MichaelMIL/intent2026/04-fab/drc-report.txt

** Drc report for intent-2026-badge.kicad_pcb **
** Created on 2026-10-29T23:50:27 **
** Report includes: Errors, Warnings, Exclusions **

** Found 2 DRC violations **
[silk_edge_clearance]: Silkscreen clipped by board edge
    Rule: board setup constraints silk; warning (excluded)
    @(156.0000 mm, 61.0000 mm): Segment on Edge.Cuts
    @(155.1500 mm, 98.9000 mm): Segment of J1 on F.Silkscreen
[silk_edge_clearance]: Silkscreen clipped by board edge
    Rule: board setup constraints silk; warning (excluded)
    @(156.0000 mm, 61.0000 mm): Segment on Edge.Cuts
    @(155.1500 mm, 108.3000 mm): Segment of J1 on F.Silkscreen

** Found 0 unconnected pads **

** Found 0 Footprint errors **

** Ignored checks **
    - Footprint has no courtyard defined
    - Track endpoint not centered on via
    - Tuning profile track geometries
    - Footprint doesn't match symbol's footprint filters
    - Silkscreen clearance
    - Footprint component type doesn't match footprint pads
    - Footprint not found in libraries
    - Footprint doesn't match copy in library

** End of Report **
