MichaelMIL/intent2026/04-fab/cpl_rotation_report.txt

CPL corrections applied (JLC/EasyEDA footprint orientation vs KiCad):
D1    C2286      KiCad rot   0.0 -> JLC rot 180.0, offset (-0.000, -0.000) mm, fit err 0.037 mm
D2    C2286      KiCad rot   0.0 -> JLC rot 180.0, offset (-0.000, -0.000) mm, fit err 0.037 mm
D3    C2286      KiCad rot   0.0 -> JLC rot 180.0, offset (-0.000, -0.000) mm, fit err 0.037 mm
D4    C2286      KiCad rot   0.0 -> JLC rot 180.0, offset (-0.000, -0.000) mm, fit err 0.037 mm
D5    C2286      KiCad rot   0.0 -> JLC rot 180.0, offset (-0.000, -0.000) mm, fit err 0.037 mm
Q1    C22469449  KiCad rot   0.0 -> JLC rot 180.0, offset (0.054, 0.000) mm, fit err 0.145 mm
Q2    C2146      KiCad rot   0.0 -> JLC rot 180.0, offset (0.054, 0.000) mm, fit err 0.145 mm
U2    C2456211   KiCad rot   0.0 -> JLC rot 270.0, offset (-0.000, 0.000) mm, fit err 0.207 mm
U4    C2827654   KiCad rot   0.0 -> JLC rot 270.0, offset (0.000, -0.000) mm, fit err 0.012 mm

NOT verifiable by pad geometry (symmetric pad pattern, 0 and 180 deg fit equally; 0 assumed).
Check these in the JLC placement preview before paying:
  D6     C7420330   SOD-123 Schottky: cathode (KiCad pad 1) towards U3 / VSYS. Reversed = no USB power.
  U5     C91447     IRM-H638T: GND pair (pins 1,2) on the J4 side. 180 deg wrong puts VCC on a GND pad.
  LED1-4 C52917434  WS2812B-2020: pin 1 (DOUT) corner as in the KiCad footprint.
  Y1     C20625731  ABM8-272-T3 3225 crystal: 180 deg is harmless, 90 deg shorts the crystal to GND.
  D1-D5  C2286      cathode = KiCad pad 1 (CPL already rotated 180 deg for JLC).
  D7     C81598     1N4148W SOD-123 on the SPK module: cathode (KiCad pad 1) towards SPM_3V3 / LS1 side.
  LS1    C94599     MLT-8530: lead row (+/-) towards the module header P3. The footprint wires the dummy pads
                    crosswise, so 180 deg only reverses the coil; 90 deg = silent but harmless.
  J5-J7  C42163131  SAO 2x3 SMD socket, P1-P3 C3294461 SAO 2x3 SMD header: a 180 deg error swaps 3V3/GND with
                    GPIO pins: pin 1 must match the silk triangle.
rev 0.6 parts with NO JLC footprint data in jlc_footprints.json (no correction applied, check in the preview):
  J1 C165948 HRO TYPE-C-31-M-12, U3 C51118 AP2112K SOT-23-5 (pin 1 = VIN), U6 C100024 SN74LV1T34 SOT-23-5,
  J5-J7 C42163131, P1-P3 C3294461, U7 C967633 LSM6DS3TR-C LGA-14 (pin 1 dot!), J3 C160352.
