MichaelMIL/intent2026/04-fab/erc-report.txt

ERC report (2026-10-29T23:01:08, Encoding UTF8)
Report includes: Errors, Warnings, Exclusions

***** Sheet /
[pin_to_pin]: Pins of type Bidirectional and Power output are connected
    ; warning
    @(96.52 mm, 368.30 mm): Symbol U7 Pin 1 [SDO/SA0, Bidirectional, Line]
    @(535.94 mm, 302.26 mm): Symbol #FLG073 Pin 1 [Power output, Line]
[pin_to_pin]: Pins of type Bidirectional and Power output are connected
    ; warning
    @(96.52 mm, 370.84 mm): Symbol U7 Pin 2 [SDX, Bidirectional, Line]
    @(535.94 mm, 302.26 mm): Symbol #FLG073 Pin 1 [Power output, Line]

 ** ERC messages: 2  Errors 0  Warnings 2

 ** Ignored checks:
    - Global label only appears once in the schematic
    - Four connection points are joined together
    - SPICE model issue
    - Assigned footprint doesn't match footprint filters
