MichaelMIL/intent2026/01-spec/rp2040-review-2026-10-17.md

# INTENT 2026 badge: schematic/BOM review vs RP2040 reference design (2026-10-17)

Reference: Raspberry Pi *Hardware design with RP2040* (RP-008279-DS), chapter 2 "Minimal design example".
Tooling: kicad-happy @ 6a91aaa (analyze_schematic, analyze_pcb --full, cross_analysis, analyze_emc,
analyze_thermal, analyze_gerbers) run on the working-tree schematic (includes the C10/C18/C26 edit, see §0)
and the committed rev 0.5 PCB / gerbers.

## Verdict

Not ready to order. The RP2040 core matches the reference except for the VREG decoupling (now fixed in the
schematic, not yet on the PCB) and the crystal choice. The real design risks are on the power side: the
WS2812 LEDs on VSYS (supply range and data level) and the 3V3 regulator current budget. Two new items from
kicad-happy are worth acting on: no capacitor on VBUS, and USBLC6 VBUS pin undecoupled.

## 0. State of the files (updated after the user's decisions)

All items below except TP1–TP3 (kept) were applied to `design.py` / `gen_sch.py` and the schematic was
regenerated: `check_sch.py --erc` 317 pins, 79 nets, 0 problems, ERC 0 errors / 0 warnings. BOM changes are in
`00-bom/bom-deltas.md` (rev 0.6) and the Hebrew mirror. RGB went with the buffer (SN74LV1T34, C100024), because no
LCSC/JLC addressable LED is rated for a 3.0–3.3 V supply. The PCB is not re-laid out yet (BUILD-NOTES item 14).

## 1. Blockers / should-fix

| # | Item | Evidence | Proposal |
|---|---|---|---|
| 1 | VREG decoupling | Guide §2.1.3: "1 µF capacitors close to both the input (VREG_IN) and the output (VREG_OUT)", 100 nF per DVDD pin. Old netlist: 100 nF on VREG_VIN, one 1 µF shared VREG_VOUT/DVDD50 | Done in schematic (§0). PCB: place C26 by pin 45, C18 by pin 44 |
| 2 | Crystal | Y1 C133334 is CL 20 pF; analyzer: effective load 10.5 pF (15 pF/2 + 3 pF stray). Guide §2.3.1 recommends ABM8-272-T3 (CL 10 pF, ESR 50 Ω, ±30 ppm) tuned with 15 pF + 1 kΩ | Swap Y1 → ABM8-272-T3, LCSC **C20625731** (3225-4P, same footprint, ~$0.38 @1k, 6.6k stock). Keep C11/C12 15 pF, R13 1 k |
| 3 | WS2812B-2020 on VSYS | Datasheet: VDD 3.7–5.3 V, VIH = 0.7·VDD. Battery end-of-life VSYS ≈ 3.0 V (below range: blue/green fail first). On USB VSYS ≈ 4.6 V → VIH ≈ 3.2 V vs a 3.3 V GPIO (no margin). Analyzer: 4 LEDs ≈ 240 mA peak on VSYS | (a) Keep VSYS supply, add 74AHCT1G125 (VCC = VSYS) as data buffer: fixes level, not low battery. (b) Move LEDs to +3V3 with a part rated for 3.3 V supply (part to be selected; needs the bigger LDO, item 4). Firmware brightness cap either way |
| 4 | U3 current budget | ME6206 is a 200 mA-class LDO. Load: RP2040 + flash (~30–50 mA) + speaker module 95 mA + IR + J2 3V3 | Swap to **AP2112K-3.3TRG1, LCSC C51118** (600 mA, 250 mV dropout @600 mA, Vin max 6 V). Note: LCSC C23380830 is a TECH PUBLIC part with the same MPN, not Diodes. SOT-23-5: 1 VIN, 2 GND, 3 EN → VIN, 4 NC, 5 VOUT. Caps: keep C9 10 µF in, C20 1 µF → 10 µF out (0805) |
| 5 | No capacitor on VBUS (new, kicad-happy UC-001 / DC-002) | VBUS has only D6, R10, R15, U4 pin 5. USBLC6-2SC6 app note puts 100 nF on VBUS pin 5 | Add 1 µF + 100 nF on VBUS near J1/U4 (stay ≤ 10 µF for USB inrush) |

## 2. Your list, item by item

- **USB-C → HRO TYPE-C-31-M-12, LCSC C165948**: agree. 16P USB 2.0, $0.10 @1k, 348k stock. Needs a footprint
  in `gen_fp.py` from the EasyEDA data, J1 re-placement and local re-route. The current J1 courtyard overhangs
  the edge by 0.54 mm (PM-002); recheck after the swap. CC 5.1 k ×2, 27 Ω series, USBLC6 all match the guide §2.4.1.
- **U3 → AP2112K-3.3**: agree, see item 4.
- **Expansion ports → SAO**: SAO = 2×3 2.54 mm, keyed female socket on the badge, shrouded male header on the
  add-on. Pins 1 3V3, 2 GND, 3 SDA, 4 SCL, 5 GPIO1, 6 GPIO2. Implications: shared I²C bus + pull-ups (e.g. 4.7 k)
  on the badge, GPIO1/GPIO2 per port (IR_OUT / AUDIO_PWM / SPK_PWM become GPIO1), 2×3 headers on the 13 × 22 mm
  cans (fits), re-route of the module area. Free I²C-capable pins: GPIO0/1 (I2C0) if TP1–3 go, or GPIO12/13,
  GPIO20/21. Spec also suggests an ID EEPROM at 0x50 on add-ons (optional for ours).
- **RGB at 3.0 V**: see item 3.
- **TP1–TP3**: not needed for users. stdio goes over USB CDC; UART0 only matters for low-level debug, and J2
  already gives SWD. They cost nothing in BOM (THT pads, not populated) but use board area. Recommend removing
  them and using GPIO0/1 as the SAO I²C bus.
- **C10 → 100 nF**: agree, done (§0).
- **VREG_VIN / VREG_VOUT decoupling**: agree, done (§0).
- **Crystal → ABM8-272-T3**: yes, switch (item 2). Drop-in footprint and it makes the existing load caps correct.

## 3. Other checks vs the reference (match unless noted)

- IOVDD 100 nF ×6, USB_VDD 100 nF, ADC_AVDD 100 nF, DVDD 100 nF ×2: match (guide even shares one cap on 48/49).
- TESTEN (pin 19) → GND; QSPI_SS 10 k pull-up + 1 k to BOOTSEL: match (guide fits the 10 k as DNF).
- RUN: 10 k pull-up, **no reset button**. On battery, entering BOOTSEL requires removing USB and batteries.
  Suggest a second TS-1187A (C318884) from RUN to GND.
- Flash W25Q16JV (2 MB) on QSPI: fine.
- USB D+/D− skew 7.5 mm and layer changes (DP-001/003): the 25 ps limit is for High Speed; irrelevant at
  12 Mbit/s full speed. False positive.

## 4. kicad-happy findings triaged

| Finding | Verdict |
|---|---|
| UC-001 no VBUS cap, DC-002 U4 no decap | Real, item 5 |
| XV-001/002 C26 missing, C10/C18 values | Expected until the PCB is regenerated |
| DS-001 / SS-001 no MPNs, no datasheets dir | Parts carry LCSC numbers only. Pin-level checks here are consistency-only except the RP2040 items checked against the HW design guide. Adding MPN fields would enable kicad-happy datasheet sync |
| FD-001 no fiducials | JLC adds panel fiducials; optional |
| PM-002 J1 courtyard over edge | Normal for edge USB-C; recheck with C165948 |
| RS-001 VBUS_SENSE no source | Analyzer artefact: it is a divider output to GPIO29/ADC3 (pin type bidirectional) |
| GP-001 / PS-002 / RP-001 plane gaps, missing stitching vias | Expected on 2-layer with +3V3/VSYS pours; worth a look at the QSPI and USB routes during the re-layout |
| IO-001 no filtering J4/J6/P2 | Badge, no EMC certification target; ignore |
| GR-004 paste/copper ratio | Expected (THT parts, mask-opening art) |
| EMC score 0/100 | Dominated by the 2-layer plane-gap rules above; not a design blocker for a badge |

## 5. Not performed / limits

- SPICE: no simulator installed (ngspice / LTspice / Xyce not found).
- Thermal: skipped by the analyzer (no power data without datasheet extraction).
- Lifecycle audit: no MPN fields.
- Datasheet sync: no `datasheets/` directory, no distributor API keys.
- ERC / DRC on the regenerated schematic: not run.

## 6. Follow-up 2026-10-18

SAO connectors changed to SMT (J5–J7 C42163131, P1–P3 C3294461). Keyed connectors checked: keyed SMT box headers exist
(BH254VS-6P C492445) but no board-mount keyed female mate, so keying is not possible within the SAO standard with stock
parts. Details in `00-bom/bom-deltas.md` rev 0.6b.
