MichaelMIL/intent2026/04-fab/archive-rev0.5/drc-report.txt

** Drc report for intent-2026-badge.kicad_pcb **
** Created on 2026-10-13T23:38:59 **
** Report includes: Errors, Warnings, Exclusions **

** Found 0 DRC violations **

** Found 0 unconnected pads **

** Found 86 Footprint errors **
[footprint_symbol_field_mismatch]: Field 'Description' differs (PCB: '', Schematic: 'IOVDD')
    Local override; warning
    @(133.6000 mm, 105.0000 mm): Footprint C1
[footprint_symbol_field_mismatch]: Field 'Description' differs (PCB: '', Schematic: 'IOVDD')
    Local override; warning
    @(133.6000 mm, 96.2000 mm): Footprint C2
[footprint_symbol_field_mismatch]: Field 'Description' differs (PCB: '', Schematic: 'IOVDD')
    Local override; warning
    @(135.2000 mm, 94.6000 mm): Footprint C3
[footprint_symbol_field_mismatch]: Field 'Description' differs (PCB: '', Schematic: 'IOVDD')
    Local override; warning
    @(123.4000 mm, 104.6000 mm): Footprint C4
[footprint_symbol_field_mismatch]: Field 'Description' differs (PCB: '', Schematic: 'IOVDD')
    Local override; warning
    @(125.9000 mm, 105.2000 mm): Footprint C5
[footprint_symbol_field_mismatch]: Field 'Description' differs (PCB: '', Schematic: 'flash VCC')
    Local override; warning
    @(134.0000 mm, 114.0000 mm): Footprint C6
[footprint_symbol_field_mismatch]: Field 'Description' differs (PCB: '', Schematic: 'USB_VDD')
    Local override; warning
    @(124.9000 mm, 107.2000 mm): Footprint C7
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
    Local override; warning
    @(147.1000 mm, 164.3000 mm): Footprint D7
[footprint_symbol_field_mismatch]: Field 'Description' differs (PCB: '', Schematic: 'Mounting Hole without connection')
    Local override; warning
    @(112.0000 mm, 55.5000 mm): Footprint H1
[footprint_symbol_field_mismatch]: Field 'Description' differs (PCB: '', Schematic: 'Mounting Hole without connection')
    Local override; warning
    @(144.0000 mm, 55.5000 mm): Footprint H2
[footprint_symbol_field_mismatch]: Field 'Datasheet' differs (PCB: '', Schematic: 'https://www.usb.org/sites/default/files/documents/usb_type-c.zip')
    Local override; warning
    @(151.3400 mm, 134.0000 mm): Footprint J1
[footprint_symbol_field_mismatch]: Field 'Description' differs (PCB: '', Schematic: '2x13 expansion / SWD, DNP')
    Local override; warning
    @(103.6000 mm, 81.0000 mm): Footprint J2
[footprint_symbol_field_mismatch]: Field 'Description' differs (PCB: '', Schematic: 'Battery box plug, pin1 = +')
    Local override; warning
    @(120.0000 mm, 145.2000 mm): Footprint J3
[footprint_symbol_field_mismatch]: Field 'Description' differs (PCB: '', Schematic: 'Audio Jack, 4 Poles (TRRS)')
    Local override; warning
    @(129.0000 mm, 159.0000 mm): Footprint J4
[footprint_symbol_field_mismatch]: Field 'Description' differs (PCB: '', Schematic: 'Expansion port IR: 1 = GND, 2 = 3V3, 3 = IR_OUT')
    Local override; warning
    @(104.5000 mm, 132.4600 mm): Footprint J5
[footprint_symbol_field_mismatch]: Field 'Description' differs (PCB: '', Schematic: 'Expansion port AUDIO: 1 = GND, 2 = 3V3, 3 = AUDIO_PWM')
    Local override; warning
    @(111.5000 mm, 132.4600 mm): Footprint J6
[footprint_symbol_field_mismatch]: Field 'Description' differs (PCB: '', Schematic: 'Expansion port SPK: 1 = GND, 2 = 3V3, 3 = SPK_PWM')
    Local override; warning
    @(118.5000 mm, 132.4600 mm): Footprint J7
[footprint_symbol_field_mismatch]: Field 'Description' differs (PCB: '', Schematic: 'Solder Jumper, 2-pole, closed/bridged')
    Local override; warning
    @(130.5000 mm, 141.0000 mm): Footprint JP1
[footprint_symbol_field_mismatch]: Field 'Datasheet' differs (PCB: '', Schematic: 'https://cdn-shop.adafruit.com/product-files/4684/4684_WS2812B-2020_V1.3_EN.pdf')
    Local override; warning
    @(144.0000 mm, 86.0000 mm): Footprint LED1
[footprint_symbol_field_mismatch]: Field 'Datasheet' differs (PCB: '', Schematic: 'https://cdn-shop.adafruit.com/product-files/4684/4684_WS2812B-2020_V1.3_EN.pdf')
    Local override; warning
    @(134.0000 mm, 86.0000 mm): Footprint LED2
[footprint_symbol_field_mismatch]: Field 'Datasheet' differs (PCB: '', Schematic: 'https://cdn-shop.adafruit.com/product-files/4684/4684_WS2812B-2020_V1.3_EN.pdf')
    Local override; warning
    @(124.0000 mm, 86.0000 mm): Footprint LED3
[footprint_symbol_field_mismatch]: Field 'Datasheet' differs (PCB: '', Schematic: 'https://cdn-shop.adafruit.com/product-files/4684/4684_WS2812B-2020_V1.3_EN.pdf')
    Local override; warning
    @(114.0000 mm, 86.0000 mm): Footprint LED4
[footprint_symbol_field_mismatch]: Field 'Description' differs (PCB: '', Schematic: 'Magnetic transducer 2.7 kHz, 16 ohm, 95 mA max')
    Local override; warning
    @(144.0000 mm, 158.0000 mm): Footprint LS1
[footprint_symbol_field_mismatch]: Field 'Description' differs (PCB: '', Schematic: 'Module pins, mate with J5')
    Local override; warning
    @(109.4600 mm, 171.0000 mm): Footprint P1
[footprint_symbol_field_mismatch]: Field 'Description' differs (PCB: '', Schematic: 'Module pins, mate with J6 (3V3 pin unused)')
    Local override; warning
    @(125.4600 mm, 171.0000 mm): Footprint P2
[footprint_symbol_field_mismatch]: Field 'Description' differs (PCB: '', Schematic: 'Module pins, mate with J7')
    Local override; warning
    @(141.4600 mm, 171.0000 mm): Footprint P3
[footprint_symbol_field_mismatch]: Field 'Datasheet' differs (PCB: '', Schematic: 'http://www.aosmd.com/pdfs/datasheet/AO3401A.pdf')
    Local override; warning
    @(135.6000 mm, 132.4000 mm): Footprint Q1
[footprint_symbol_field_mismatch]: Field 'Description' differs (PCB: '', Schematic: 'NPN low-side driver')
    Local override; warning
    @(140.7000 mm, 164.9500 mm): Footprint Q2
[footprint_symbol_field_mismatch]: Field 'Description' differs (PCB: '', Schematic: 'Resistor')
    Local override; warning
    @(146.4000 mm, 136.6000 mm): Footprint R1
[footprint_symbol_field_mismatch]: Field 'Description' differs (PCB: '', Schematic: 'Resistor')
    Local override; warning
    @(146.4000 mm, 131.4000 mm): Footprint R2
[footprint_symbol_field_mismatch]: Field 'Description' differs (PCB: '', Schematic: 'Resistor')
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
    Local override; warning
    @(137.0000 mm, 145.0000 mm): Footprint TP1
[footprint_symbol_field_mismatch]: Field 'Description' differs (PCB: '', Schematic: 'test point')
    Local override; warning
    @(140.5000 mm, 145.0000 mm): Footprint TP2
[footprint_symbol_field_mismatch]: Field 'Description' differs (PCB: '', Schematic: 'test point')
    Local override; warning
    @(144.0000 mm, 145.0000 mm): Footprint TP3
[footprint_symbol_field_mismatch]: Field 'Datasheet' differs (PCB: '', Schematic: 'https://datasheets.raspberrypi.com/rp2040/rp2040-datasheet.pdf')
    Local override; warning
    @(128.0000 mm, 100.0000 mm): Footprint U1
[footprint_symbol_field_mismatch]: Field 'Datasheet' differs (PCB: '', Schematic: 'http://www.winbond.com/resource-files/w25q32jv%20revg%2003272018%20plus.pdf')
    Local override; warning
    @(130.0000 mm, 110.8000 mm): Footprint U2
[footprint_symbol_field_mismatch]: Field 'Datasheet' differs (PCB: '', Schematic: 'https://www.torexsemi.com/file/xc6206/XC6206.pdf')
    Local override; warning
    @(129.6000 mm, 135.6000 mm): Footprint U3
[footprint_symbol_field_mismatch]: Field 'Datasheet' differs (PCB: '', Schematic: 'https://www.st.com/resource/en/datasheet/usblc6-2.pdf')
    Local override; warning
    @(144.4000 mm, 134.0000 mm): Footprint U4
[footprint_symbol_field_mismatch]: Field 'Datasheet' differs (PCB: '', Schematic: 'https://en.everlight.com/wp-content/plugins/ItemRelationship/product_files/pdf/DMO-0000004-IRM-H6XX-TR2_Series_Datasheet_V4.pdf')
    Local override; warning
    @(112.0000 mm, 157.0000 mm): Footprint U5
[footprint_symbol_field_mismatch]: Field 'Description' differs (PCB: '', Schematic: 'Four pin crystal, GND on pins 2 and 4')
    Local override; warning
    @(129.2000 mm, 93.0000 mm): Footprint Y1

** Ignored checks **
    - Footprint has no courtyard defined
    - Track endpoint not centered on via
    - Tuning profile track geometries
    - Footprint doesn't match symbol's footprint filters
    - Silkscreen clearance
    - Footprint component type doesn't match footprint pads
    - Footprint not found in libraries
    - Footprint doesn't match copy in library

** End of Report **
