MichaelMIL/intent2026/04-fab/archive-rev0.5/erc-report.txt

ERC report (2026-10-13T23:38:57, Encoding UTF8)
Report includes: Errors, Warnings, Exclusions

***** Sheet /
[lib_symbol_mismatch]: Symbol 'USB_C_Receptacle_USB2.0_16P' doesn't match copy in library 'Connector'
    ; warning
    @(55.88 mm, 68.58 mm): Symbol J1 [USB_C_Receptacle_USB2.0_16P]

 ** ERC messages: 1  Errors 0  Warnings 1

 ** Ignored checks:
    - Global label only appears once in the schematic
    - Four connection points are joined together
    - SPICE model issue
    - Assigned footprint doesn't match footprint filters
