MichaelMIL/intent2026/00-bom/bom-deltas-he.md

# תיקוני BOM — מה נדרש ולמה (עברית)

כל התיקונים נובעים מהשוואה בין ה-BOM לבין המדריך הרשמי של Raspberry Pi,
*Hardware design with RP2040* (פרק "Minimal Design Example"), ומדפי הנתונים של הרכיבים.

## 1. הסרת L1 — סליל 3.3µH — **נדרש**
ה-BOM מתאר אותו כ-"RP2040 1V1 buck". ל-RP2040 **אין** ממיר buck. יש לו רגולטור ליניארי פנימי (LDO)
שמוריד 3.3V ל-1.1V לליבה, והוא דורש רק קבל 1µF על VREG_VOUT. הסליל הזה שייך ל-**RP2350** (הדור הבא),
שבו באמת יש ממיר מיתוגי. אם נשאיר אותו — אין לו לאן להתחבר בסכמה. בונוס: זה היה הרכיב היחיד עם מלאי
נמוך (1,900 יח'), והוא נעלם.

## 2. נגדי 27Ω על קווי USB D+/D- — **נדרש**
במדריך של Raspberry Pi הם חובה. הרציונל: הדרייבר של ה-USB ב-RP2040 הוא "חזק מדי" ביחס לאימפדנס
הקווים (90Ω דיפרנציאלי). הנגדים בטור מתאימים את האימפדנס ומרככים את הקצוות של האותות, וכך האות עומד
בדרישות ה-eye diagram של USB 2.0 Full-Speed. בלי הנגדים לוחות **לרוב** יעבדו, אבל חלק מהמחשבים/כבלים
יתנו ניתוקים אקראיים — בדיוק סוג הבאג שקשה לאתר ב-600 יחידות בשטח. עלות: ~$0.004 ללוח, רכיב basic.

## 3. נגד 1kΩ בטור ל-XOUT של הגביש — **מומלץ מאוד**
המדריך דורש אותו. הוא מגביל את ה-drive level של הגביש (12MHz). בלי הנגד הגביש מקבל יותר הספק ממה
שהוא מתוכנן לו — זה מקצר את חייו, מזיז את התדר, ולעיתים גורם לגביש "לקפוץ" להרמוניה. התדר הזה הוא
מקור השעון של ה-USB, אז סטייה בו = USB לא יציב. עלות: אפס (אותו נגד 1kΩ שכבר ב-BOM).

## 4. נגד 1kΩ בין לחצן BOOTSEL ל-GND — **מומלץ**
ב-Pico זה בדיוק כך. QSPI_SS הוא גם קו ה-chip-select של ה-flash. כשהלחצן נלחץ תוך כדי שה-RP2040
מוציא עליו '1', בלי הנגד יש קצר ישיר של הפלט ל-GND. הנגד מגביל את הזרם ל-~3mA, שהפין סובל. עלות: אפס.

## 5. קבלי 100nF: 12 → 16 — **נדרש**
ל-RP2040 יש 10 פיני הזנה: 6× IOVDD, 2× DVDD, USB_VDD, ADC_AVDD (ועוד VREG_VIN). הכלל: קבל 100nF
צמוד לכל פין. ה-BOM הקצה 8 קבלים לכל הלוח — RP2040 + flash + LDO — כלומר חסרים לפחות 2–3 לשבב
עצמו. בלי decoupling לכל פין מקבלים רעש על ההזנה, רעש ב-ADC, ו-USB רגיש. עלות: ~$0.012 ללוח.

## 6. קבל 1µF על יציאת ה-LDO (3V3) — **נדרש**
דף הנתונים של ME6206 דורש לפחות 1µF קרמי על היציאה ליציבות. ב-BOM היה רק 10µF על הכניסה
ו-1µF אחד שמיועד ל-VREG_VOUT של ה-RP2040. בלי קבל יציאה ה-LDO יכול להתנדנד (oscillate) — זה נראה
כמו רעש של 3V3 ואיפוסים אקראיים. עלות: ~$0.007 ללוח (אותו רכיב).

## 7. פד לנגד דמפינג על קו הנתונים ל-RGB — **אופציונלי, $0**
WS2812 רגישים ל-ringing על קו הנתונים. משאירים פד 0402 בין GPIO10 ל-LED1; אם לא צריך — מגשרים.

## סיכום
| | לפני | אחרי |
|---|---|---|
| סוגי רכיבים | 17 | 17 (−L1, +27Ω) |
| נקודות הלחמה | 188 | ~206 |
| עלות רכיבים @600 | $2.04 | ~$2.04 (±$0.01) |
| סיכון מלאי | L1: 1,900 | אין |

כולם נכנסו ל-`design-spec.md` כ-R11–R14, C17–C20. אם אתה רוצה לדלג על משהו — סעיפים 3, 4, 7 הם
ה"רכים"; 1, 2, 5, 6 אני לא הייתי מוותר עליהם.

---

# גרסה 0.5 — מקלט IR, שקע אודיו ורמקול כמודולים נתיקים (החלטה 2026-10-11)

מקלט ה-IR ושקע האודיו יורדים מהלוח הראשי, מתווסף רמקול (תוספת 7 ב-BOM-B2), ושלושתם יושבים על
**לוחות-משנה נתיקים מתחת לבסיס** של מכונת המכירה: אותו PCB, מחוברים בלשוניות ברוחב 4 מ"מ עם
"נשיכות עכבר" (mouse bites), **בלי נחושת שחוצה את הלשוניות**. על כל מודול יש מחבר פינים 1×3 (P1–P3) שנכנס
לשקע 1×3 תואם על הלוח הראשי (J5–J7). פינאוט זהה בכל השקעים: **1 = GND (פד מרובע), 2 = 3V3, 3 = אות**.
ההספק באמצע, ולכן מודול שמוכנס הפוך רק מחליף בין GND לאות ולעולם לא מביא 3V3 אל GPIO.
גודל הלוח הגולמי גדל מ-56×100 ל-56×124 מ"מ (המודולים הם פחיות 13×22 מ"מ).

| רכיב | LCSC | תיאור | כמות | סוג חדש? | היכן |
|---|---|---|---|---|---|
| J5, J6, J7 | C541850 | שקע נקבה 1×3, 2.54 מ"מ, THT | 3 | כן (ext) | לוח ראשי, אזור המטבעות: IR / AUDIO / SPK (GPIO22 / 11 / 25) |
| P1, P2, P3 | C49257 | מחבר פינים 1×3, 2.54 מ"מ, THT | 3 | כן (ext) | אחד על כל מודול |
| U5, R19, C23, C24 | כמו קודם | מקלט IR + מסנן RC | 4 | לא | **מודול IR** (רשתות IRM_*) |
| J4, R17, C21, C22 | כמו קודם | שקע אודיו + מסנן PWM | 4 | לא | **מודול אודיו** (רשתות AUM_*; פין 2 לא בשימוש) |
| LS1 | C94599 | MLT-8530, זמזם מגנטי SMD, 2.7 kHz, 16Ω | 1 | כן (ext) | **מודול רמקול**, עד 95mA, מוזן מ-3V3 |
| Q2 | C2146 | S8050 NPN, SOT-23 | 1 | כן (basic) | מודול רמקול, מתג low-side |
| D7 | C81598 | 1N4148W, SOD-123 | 1 | כן (basic) | מודול רמקול, דיודת flyback. **מלאי LCSC הראה 300 ב-2026-10-11 — לבדוק מלאי JLC או לבחור 1N4148W אחר** |
| R20, R21 | C11702, C25744 | 1kΩ לבסיס, 10kΩ pull-down | 2 | לא | מודול רמקול |
| C25 | C7503495 | 10µF 0805 | 1 | לא | מודול רמקול, קבל מקומי לפולסי הסליל |

סוגי רכיבים: 23 → 28. הלחמות: ≈240 → ≈262 SMD + **18 THT** (המחברים מולחמים ידנית ב-JLC: $3.50 להזמנה +
$0.0173 להלחמה). GPIO25 נתפס לרמקול (נשאר גם על J2 פין 15 כאות משותף); נשארים 15 GPIO פנויים על J2.

**עלות (הערכה גסה, 600 לוחות, כולל מע"מ): ≈ +$0.9–1.0 ללוח** — מחברים ≈$0.24, הלחמות THT ≈$0.31,
רכיבי הרמקול ≈$0.26, PCB גדול ב-18% ≈$0.10. ב-10 לוחות העמלות הקבועות (5 סוגים חדשים × $1.53 + $3.50)
מוסיפות ≈ +$2.5 ללוח. **אפשרות זולה יותר:** להשאיר את J5–J7 ו-P1–P3 לא מורכבים (DNP, כמו J2) ולצרף מחברים
בשקית — חוסך ≈$0.55 ללוח, אבל אז צריך להלחים לפני שמודול כלשהו עובד.

למה כך: המודולים תלויים מתחת לבסיס כדי שהתג ישמור על צללית 56×100 אחרי הניתוק; נשיכות העכבר יושבות על
קצה הבסיס, כך שהשארית נשארת על המודול ולא על התג. לרשתות המודולים יש שמות משלהן, שום דבר לא עובר דרך
הלשוניות, ולכן ה-DRC על הפאנל אמין. השקעים אנכיים — מודול מחובר עומד כמו מוצר בחלון; העדשה של ה-IR
ופתח הקול פונים הצידה. אם מעדיפים מודול שוכב שפונה קדימה, מחליפים את P1–P3 למחברים בזווית ישרה
(`PinHeader_1x03_P2.54mm_Horizontal`, אותם פדים). ה-footprint של הזמזם מחבר את שני פדי הדמה בצלב לפדי
הסליל, כך ששגיאת 180° בהרכבה רק הופכת את קוטביות הסליל, ו-90° משתיק בלי נזק.

---

# גרסה 0.6 — בדיקה מול מדריך התכנון של RP2040 (2026-10-17)

בדיקת המשתמש + הרצת kicad-happy (דוח: `01-spec/rp2040-review-2026-10-17.md`). השינויים הוכנסו ל-`design.py`
ולסכמה; ה-PCB **עוד לא** עודכן (footprints חדשים: J1, U3, U6, J5–J7, P1–P3; רכיבים חדשים C26–C29, R22, R23,
SW6). TP1–TP3 נשארים (החלטת המשתמש).

| רכיב | שינוי | LCSC | למה |
|---|---|---|---|
| C18 | 100nF → **1µF** | C6119792 | מדריך §2.1.3: ‏1µF על VREG_VIN |
| C10 | 1µF → **100nF** | C60474 | עכשיו רק DVDD פין 50 |
| C26 | **חדש** 1µF על +1V1 | C6119792 | מדריך §2.1.3: ‏1µF על VREG_VOUT |
| Y1 | C133334 (CL 20pF) → **Abracon ABM8-272-T3** | **C20625731** | הגביש של המדריך; CL 10pF מתאים לקבלי 15pF ול-1k. אותו footprint ‏3225 |
| U3 | ME6206A33M3G → **AP2112K-3.3TRG1** (SOT-23-5, EN ל-VIN) | **C51118** | ‏600mA במקום LDO של ‏200mA. C23380830 הוא יצרן אחר עם אותו MPN |
| C20 | 1µF → **10µF 0805** | C7503495 | קבל יציאה של ה-LDO |
| J1 | TYPE-C-16PIN C393939 → **HRO TYPE-C-31-M-12** | **C165948** | הרכיב שעבד אצל המשתמש; footprint סטנדרטי של KiCad |
| C27, C28 | **חדש** 1µF + 100nF על VBUS | C6119792, C60474 | לא היה קבל על VBUS בכלל |
| SW6 | **חדש** כפתור RESET (RUN ל-GND) | C318884 | משתמשי סוללה מגיעים ל-BOOTSEL בלי לנתק |
| U6, C29 | **חדש** SN74LV1T34DBVR מוזן מ-VSYS + 100nF | **C100024**, C60474 | חוצץ נתונים ל-RGB: ‏DIN מגיע ל-VSYS, כך ש-VIH = 0.7·VDD מתקיים בכל מתח |
| J5–J7 | שקע 1×3 → **שקע 2×3 (SAO)** | **C541853** | SAO: ‏1 3V3, ‏2 GND, ‏3 SDA, ‏4 SCL, ‏5 GPIO1, ‏6 GPIO2 |
| P1–P3 | מחבר 1×3 → **מחבר 2×3 (SAO)** | **C65114** | מחבר רגיל: 2×3 עם מעטפת רחב מהפחית (13 מ"מ) |
| R22, R23 | **חדש** 4.7kΩ ‏pull-up ל-I²C | C25900 (basic) | ‏I²C0 של SAO על GPIO12/13 |

אפשרות RGB שלא נבחרה: אין ב-LCSC/JLC לד ממוען שמדורג לאספקה של 3.0–3.3V. הנמוכים ביותר: SK6805-EC20
(C2890036, ‏3.5–5.5V, ‏4 במלאי), WS2812B-MINI-V3 (3.5V), והשאר מ-3.7V. רכיבי XL-…-KS של "3V" מהבהבים
לבד ואינם ממוענים. לכן הלדים נשארים על VSYS ‏(WS2812B-2020-V6) עם החוצץ, והקושחה מכבה אותם כש-VSYS יורד
מתחת ל-≈3.7V.

עלות @600 (הערכה גסה): ≈ **+$0.95 ללוח** (גביש +$0.25, LDO ‏+$0.12, חוצץ +$0.18, מחברים +$0.05, פסיביים
+$0.05, הלחמות THT נוספות +$0.31). אם רכיבי ה-THT נשלחים DNP, שורת ה-THT יורדת.

## גרסה 0.6b — מחברי SAO ל-SMT, נבדקה אפשרות למחבר עם מפתח (2026-10-18)

| רכיב | היה (THT) | עכשיו (SMT) | LCSC | מלאי / מחיר (2026-10-18) |
|---|---|---|---|---|
| J5–J7 | PM254V-12-06-H85 C541853 | **HC-PM254-5.0H-2x3PS-02A**, שקע 2×3 SMD, גובה 5.0 מ"מ | **C42163131** | 7,625 / $0.116 |
| P1–P3 | 2.54-2*3P C65114 | **PZ254-2-03-S**, מחבר פינים 2×3 SMD | **C3294461** | 14,540 / $0.080 |

Footprints: ‏`PinSocket_2x03_P2.54mm_Vertical_SMD` / ‏`PinHeader_2x03_P2.54mm_Vertical_SMD` של KiCad (‏≈8 מ"מ רוחב
על שתי השורות). לבדוק מול דפי הנתונים בעימוד ה-PCB. השקע רחב יותר, אז המרווח של 7 מ"מ בין השקעים לא יספיק
ו-J5–J7 יזוזו. חלופות: שקע C41397152, מחבר C780054.

השפעה: לא נשארים רכיבי THT (חוץ מ-J2 שלא מורכב), כך שעמלת ההלחמה הידנית של JLC (‏$3.50 להזמנה + 36 הלחמות
≈ $0.62 ללוח) נעלמת. נטו מול 0.6: ≈ **‎−$0.5 ללוח**.

**מחבר עם מפתח (נבדק, לא יושם):**
- יש box header עם מפתח ב-SMT: ‏**BH254VS-6P C492445** (‏4,800 במלאי, $0.16) ו-C22438045. גוף 15.27×8.8 מ"מ.
- **אין** שקע נקבה עם מפתח להרכבה על PCB שמתאים להם ב-LCSC/JLC (בן הזוג עם המפתח הוא מחבר IDC לכבל שטוח).
  שקע 2×3 רגיל נכנס לתוך המעטפת אבל החלל באורך ≈13 מ"מ מול שקע של 7.6 מ"מ, כך שאין מפתח לכיוון ולא להיסט.
- box header נכנס לפחית של 13 מ"מ רק כשהוא מסובב ב-90°, ותופס ≈15×10.5 מ"מ מתוך 13×22.
- מסקנה: אי אפשר לקבל מפתח בתוך תקן SAO עם רכיבים מהמלאי. המלצה: SMT בלי מפתח + משולשי פין 1 גדולים על התג
  ועל כל פחית, וציור הפחית כך ש"פחית עומדת" = כיוון נכון.
- מודול שלנו שמחובר הפוך (180°) מקבל 3V3 על פין 6 שלא בשימוש, ופיני ה-3V3/GND שלו נופלים על GPIO2/GPIO1: אין קצר,
  המודול פשוט לא עובד. SAO של צד שלישי עלול לקבל מתח דרך GPIO; הקושחה משאירה את GPIO1/GPIO2 ככניסות עד שמזוהה מודול.

## גרסה 0.6d — מחבר הסוללה J3 (2026-10-29, בקשת המשתמש)

| רכיב | היה | עכשיו | LCSC | הערות |
|---|---|---|---|---|
| J3 | CAX PH2.0-2P-LT, footprint מותאם (C722761) | **JST B2B-PH-SM4-TB**, ‏JST PH 2.0 מ"מ מקורי, 2 פינים SMD אנכי, עם לשוניות הלחמה | **C160352** | ‏72,150 במלאי; ‎$0.13 (1,000+). footprint סטנדרטי של KiCad: ‏`Connector_JST:JST_PH_B2B-PH-SM4-TB_1x02-1MP_P2.00mm_Vertical`. פין 1 = BAT_IN (+), פין 2 = GND כמו קודם |

- אותו תקע PH 2.0, כך שכבל קופסת הסוללות לא משתנה. לבדוק את קוטביות התקע של הקופסה מול פין 1.
- ה-footprint השתנה: צריך Update PCB from Schematic ולמקם מחדש את J3. אין עדיין נתוני סיבוב של JLC ל-C160352: לבדוק את J3 בתצוגה המקדימה של JLC.

## גרסה 0.6e — מודול האודיו הוחלף במודול IMU (2026-10-29, בקשת המשתמש)

| רכיב | שינוי | LCSC | הערות |
|---|---|---|---|
| J4, R17, C21, C22 | **הוסרו** (שקע PJ-320D ומסנן PWM) | C431535, C11702, C15195, C19702 | מודול האודיו בוטל |
| U7 | **חדש** ST **LSM6DS3TR-C**, ‏IMU בעל 6 צירים (מד תאוצה + ג'ירו), LGA-14 2.5×3 מ"מ | **C967633** | ‏22,645 במלאי; ‎$0.91 (1,000+) |
| C30, C31 | **חדש** 100nF על VDD / VDDIO | C60474 | לפי דף הנתונים |

- מצב I2C: ‏CS = VDDIO, ‏SA0 = GND ← כתובת **0x6A**, ‏SDx/SCx = GND, פינים 10/11 לא מחוברים. SDA/SCL על אפיק ה-I2C של SAO (נגדי pull-up R22/R23 על התג). INT1 → GPIO1 של SAO (GPIO11, הרשת שונתה מ-AUDIO_PWM ל-IMU_INT1), INT2 → GPIO2 של SAO (GPIO27).
- עלות ב-600: ≈ ‎+$0.95 ללוח עבור U7 והקבלים, ‎−$0.25 עבור השקע והמסנן.

## גרסה 0.6f — מחבר למסך OLED ‏0.96" (2026-10-29, בקשת המשתמש)

| רכיב | שינוי | LCSC | הערות |
|---|---|---|---|
| J8 | **חדש** שקע נקבה 1×4 ‏2.54 מ"מ SMD, ‏HX PM2.54-1x4P TP-YQ, גובה 5 מ"מ | **C42379197** | ‏15,269 במלאי. למודול OLED ‏0.96" ‏SSD1306 ב-I2C: ‏1 GND, ‏2 VCC (3V3), ‏3 SCL, ‏4 SDA, על אפיק ה-I2C של SAO. לבדוק את סדר הפינים של המודול (בחלק מהם GND ו-VCC הפוכים) |
