MichaelMIL/intent2026/04-fab/bom_jlc.csv

Comment | Designator | Footprint | LCSC Part #
100nF | C1,C2,C3,C4,C5,C6,C7,C8,C10,C13,C14,C15,C16,C17,C19,C23,C28,C29,C30,C31 | C_0402_1005Metric | C60474
10uF | C9,C20,C24,C25 | C_0805_2012Metric | C7503495
15pF | C11,C12 | C_0402_1005Metric | C1548
1uF | C18,C26,C27 | C_0402_1005Metric | C6119792
Red | D1,D2,D3,D4,D5 | LED_0603_1608Metric | C2286
B5819W | D6 | D_SOD-123 | C7420330
1N4148W | D7 | D_SOD-123 | C81598
TYPE-C-31-M-12 | J1 | USB_C_Receptacle_HRO_TYPE-C-31-M-12 | C165948
BATT 3xAAA | J3 | JST_PH_B2B-PH-SM4-TB_1x02-1MP_P2.00mm_Vertical | C160352
SAO socket 2x3 2.54mm SMD | J5,J6,J7 | PinSocket_2x03_P2.54mm_Vertical_SMD | C42163131
OLED 0.96 I2C | J8 | PinSocket_1x04_P2.54mm_Vertical_SMD_Pin1Right | C42379197
WS2812B-2020-V6 | LED1,LED2,LED3,LED4 | LED_WS2812B-2020_PLCC4_2.0x2.0mm | C52917434
MLT-8530 | LS1 | Buzzer_MLT-8530_C94599 | C94599
SAO pin header 2x3 2.54mm SMD | P1,P2,P3 | PinHeader_2x03_P2.54mm_Vertical_SMD | C3294461
HL3401 | Q1 | SOT-23 | C22469449
S8050 | Q2 | SOT-23 | C2146
5.1k | R1,R2 | R_0402_1005Metric | C25905
10k | R3,R4,R10,R15,R16,R21 | R_0402_1005Metric | C25744
1k | R5,R6,R7,R8,R9,R13,R14,R20 | R_0402_1005Metric | C11702
27 | R11,R12 | R_0402_1005Metric | C25100
100 | R19 | R_0402_1005Metric | C25076
4.7k | R22,R23 | R_0402_1005Metric | C25900
TS-1187A-B-A-B tactile 5.1x5.1 | SW1,SW2,SW3,SW4,SW6 | SW_Push_1P1T_XKB_TS-1187A | C318884
RP2040 | U1 | QFN-56-1EP_7x7mm_P0.4mm_EP3.2x3.2mm | C2040
W25Q16JVSNIQ | U2 | SOIC-8_3.9x4.9mm_P1.27mm | C2456211
AP2112K-3.3TRG1 | U3 | SOT-23-5 | C51118
USBLC6-2SC6 | U4 | SOT-23-6 | C2827654
IRM-H638T/TR2 | U5 | IRM-H638T_C91447 | C91447
SN74LV1T34DBVR | U6 | SOT-23-5 | C100024
LSM6DS3TR-C | U7 | LGA-14_3x2.5mm_P0.5mm_LayoutBorder3x4y | C967633
12MHz ABM8-272-T3 | Y1 | Crystal_SMD_3225-4Pin_3.2x2.5mm | C20625731
