MichaelMIL/intent2026/03-kicad/BUILD-NOTES.md

# 03-kicad — build notes (rev 0.6, 2026-10-18)

KiCad project, regenerated with **KiCad 10.0.3** on the Mac on 2026-10-11 (the board file is now in the v10 format; the schematic is still written in the 2025 format and opens in 9 and 10). Open `intent-2026-badge.kicad_pro`. The project folder holds custom footprints in `intent.pretty` (they are registered in `fp-lib-table`).

**rev 0.5:** the IR receiver, the audio jack and a new speaker are **breakaway modules** under the pedestal. Blank 56 × 124 mm: badge 56 × 100 + a 2 mm routed gap + three 13 × 22 mm soda-can modules on 4 mm tabs with 4 × 0.5 mm mouse bites each (MB1–MB3, board-only footprints on the pedestal edge line). Sockets J5/J6/J7 (IR/AUDIO/SPK) on the main board, pin headers P1/P2/P3 on the modules, pin 1 = GND, 2 = 3V3, 3 = signal. Module nets are prefixed IRM_/AUM_/SPM_; no copper crosses a tab; each module has its own ground pour. Details and cost in `../00-bom/bom-deltas.md` (rev 0.5) and `../01-spec/design-spec.md` §3.11.

## Status
| Check | Result |
|---|---|
| ERC | rev 0.6: 0 errors, 0 warnings (J1 is on the stock HRO footprint now, so the shield-pin rename is gone) |
| DRC (with schematic parity) | **rev 0.6: 0 errors, 0 unconnected** (KiCad 10.0.6, Windows). 31 warnings: 20 `silk_over_copper` + 10 `silk_edge_clearance` (silk clipped by mask/edge: footprint silk at the can bottoms and J1, the rotated can labels) and 1 `isolated_copper` (a sliver of AUM_GND pour on B.Cu at the AUDIO can's top-left corner). Plus the 94 cosmetic KiCad 10 `footprint_symbol_field_mismatch` notes. |
| Routing | **rev 0.6: 1677 track segments, 461 vias (87 GND stitching), full re-route (item 16).** rev 0.5: 2 layers, 1305 track segments, 378 vias (0.3/0.6) after the can re-route and the art-region via pruning (items 12–13; the rev 0.5 full run had 1313 / 412, 194 GND of which 134 stitching). Pours: GND on both layers over the badge; IRM_GND / AUM_GND / SPM_GND on the three modules. Netlist: 86 parts, 78 nets. |
| Fab outputs | `../04-fab/` (rev 0.6, 2026-10-18; rev 0.5 set in `../04-fab/archive-rev0.5/`, its routes in `build/routes_rev0.5.json`; the rev 0.4 set is in `../04-fab/archive-rev0.4/`, the rev 0.4 board in `build/rev0.4/`) |

## How the files are generated (all scripted, reproducible)
`scripts/design.py` is the netlist source of truth, and `scripts/placement.py` holds the coordinates.
1. `gen_fp.py` → `intent.pretty` (USB-C C393939, PJ-320D C431535, IRM-H638T C91447, JST-PH C722761, MLT-8530 C94599, lanyard hole, mouse bites). Pad geometry is copied from the JLC/EasyEDA footprints of those exact LCSC parts. The MLT-8530 footprint numbers its two dummy pads crosswise (1/2), so a 180° placement only reverses the coil. `gen_3d.py` → `intent.3dshapes/` simplified VRML models for these footprints and for the three stock footprints without a shipped STEP model (`pcb_build.FALLBACK_3D`); `add_3d.py` attaches them to an already finished board.
2. `gen_sch.py` → `.kicad_sch`, a **wired schematic** (2026-10-11 rework): nine blocks on one A2 sheet (USB-C, power path, expansion ports, IR module, RP2040 core, UI, header, audio module, speaker module). Rails use power symbols, every other net carries a global label with the design.py net name, so the PCB netlist is unchanged. Drawing primitives are in `schlib.py`; `check_sch.py --erc` exports the netlist and proves every (ref, pin) → net matches design.py, then runs ERC. `render_sch.py` makes a PNG for a visual check. The previous labels-only schematic is kept as `build/intent-2026-badge.kicad_sch.v1-labels.bak`.
3. `pcb_build.py` (KiCad Python) → unrouted board + `build/geo.json`. Draws the badge outline, splits the pedestal edge at the tabs, adds the tab sides and the can outlines (rectangles with the R 2.2 corners from `placement.MODULE_CORNERS`) as one closed Edge.Cuts contour, and places the mouse-bite footprints (`SetBoardOnly`, excluded from BOM/CPL and from schematic parity). `geo.json` carries the full polygon (router) and the badge-only polygon (pours, silk).
4. `router/route2.py` routes the board with a negotiated-congestion grid router: exact clearances, A* in C (`astar.c`), and a final GND fan-out pass into the main B.Cu plane.
5. `pcb_finish.py` → tracks, pours, silkscreen (`silk.py`, logo from `art_logo.py`). Pours: GND over the badge polygon only (it stops at the pedestal edge), plus IRM_GND / AUM_GND / SPM_GND over the three module rectangles. The 0.5 mm clearance on the mouse-bite holes keeps copper off the break line. `router/gnd_repair.py` + `island_stitch.py` check the main ground; module grounds are routed as ordinary nets.
6. `fab_export.py` → JLC BOM/CPL with rotation correction taken from `jlc_footprints.json`. `kicad-cli` produces the Gerbers and drill files.
`build_prep.sh` / `build_finish.sh` run the chain. 2026-10-11: run on the Mac with KiCad 10.0.3 (`scripts/env.mac.sh`, see CLAUDE.md); two KiCad 10 API renames are handled with fallbacks (`HasField`/`GetField`). The router grid was extended to y 120 for the modules (`NY = 1210`).
Router settings used for the rev 0.5 board (run from a scratch copy `$W`):
```
ROUTE_ITERS=60 FIXED_ROUTES=$W/scripts/router/fixed_routes.json GND_SKIP=U1.19 GND_LAST=1 \
GND_SUBSET=U2.4,Y1.4,C17.2,R10.2,C8.2,C7.2,C5.2,C4.2,C19.2,C18.2,C10.2,C1.2 CORR_R=6.5 HIST_INC=30 PRES_CAP=150000 \
ROUTE_STATE=$W/route_state.pkl python3 scripts/router/route2.py $W/geo.json $W/routes.json
```
`fixed_routes.json` pre-places the TESTEN (U1.19) ground fan-out to the crystal GND pad Y1.4 (the corridor between XIN and GPIO15, taken from the rev 0.4 board); the negotiation alone ended with XIN and that fan-out 0.05 mm apart. Every other net routes around fixed copper. If a run ends with a few residual conflicts that all involve GND, `router/gnd_final.py geo.json routes.json` keeps the signal nets and re-does only the GND fan-outs with hard clearance (plus stitching). `ROUTE_STATE` lets a run resume with more `ROUTE_ITERS`.
rev 0.4 settings for reference: `GND_LAST=1 GND_SUBSET=U2.4,U1.19,R10.2,C8.2,C7.2,C5.2,C4.2,C19.2,C18.2,C10.2,C1.2 CORR_R=6.5 HIST_INC=30 PRES_CAP=150000`.

## Changes against design-spec rev 0.3 (all reflected in the files)
14. **rev 0.6 schematic/BOM review (2026-10-17, user list + kicad-happy, report `../01-spec/rp2040-review-2026-10-17.md`).** `design.py` + `gen_sch.py` updated, schematic regenerated on Windows with KiCad 10.0.3 (`check_sch.py --erc`: 317 pins, 79 nets, 0 problems; ERC 0 errors, 0 warnings). Changes: VREG decoupling per the RP2040 guide (C18 1 µF VREG_VIN, C10 100 nF DVDD 50, new C26 1 µF VREG_VOUT); Y1 ABM8-272-T3; U3 AP2112K-3.3 (SOT-23-5) + C20 10 µF; J1 HRO TYPE-C-31-M-12 on the stock KiCad footprint (shield pad `SH`, so `schlib.PIN_RENAMES` is now empty and the J1 ERC warning is gone); C27/C28 on VBUS; SW6 RESET; U6 SN74LV1T34 RGB buffer + C29; J5–J7/P1–P3 → SAO 2×3 with I²C0 on GPIO12/13 (R22/R23) and GPIO2 on GPIO26–28; nets renamed GPIO10 → RGB_CTRL, GPIO12/13 → SAO_SDA/SCL, GPIO26–28 → SAOn_GPIO2. **The PCB has not been re-laid out:** `placement.py` needs C26–C29, R22, R23, SW6, U6 and the new J1/U3/J5–J7/P1–P3 footprints, then a full re-route; the `intent:USB_C_TYPE-C16PIN_C393939` footprint and its fallback 3D model become unused. `04-fab/` is stale until then.
16. **rev 0.6 PCB re-layout (2026-10-18, user request "layout according to the reference design"), built on Windows.**
    - RP2040 core after the hardware design guide: C18 (1 uF VREG_VIN) and C26 (1 uF VREG_VOUT) directly under pins 44/45, then ADC_AVDD C8, DVDD 50 C10, USB_VDD C7, IOVDD 49 C5 in one row under pins 43-50; the 27R terminations R12/R11 right under USB pins 46/47; flash U2 1.5 mm lower (y 62.3) to make room; R14 (QSPI_SS to BOOTSEL) moved from SW1 to the flash next to R3, as the guide asks. C19 (DVDD 23) stays at its rev 0.5 spot 3 mm out: right above pin 23 it blocked the SWCLK/SWDIO/RUN fan-out and the router could not close. kicad-happy decoupling distances to U1: 1 uF caps 1.3/1.4 mm (was 3.6/4.1), DVDD 50 1.7 mm.
    - New parts: U6 + C29 between U1 and LED1, SW6 RESET in the product window under the shelf (silk RESET), C27/C28 around U4, R22/R23 below CREDIT, HRO J1 at x 53.15 (shell 0.8 mm past the edge; y 84.6 keeps its rear shield pads 0.3 mm off the foot notch and its courtyard clear of SW4), U3/C20/C9 shifted right/down for the SOT-23-5. SAO sockets J5-J7 at rot 90 on an 8.8 mm pitch (x 4.65/13.45/22.25), headers P1-P3 at module (6.5, 18.6). SPK can: LS1 0.5 mm up, driver row between it and the header; AUDIO can: R17/C21/C22 in one row under the jack, which needed C22 as 0603 (C19702, same 10 uF).
    - Silk: ITEM PICKUP door resized, pin-1 triangles on the sockets and the cans instead of G/+/S, can labels moved (IR band above the header, AUDIO/SPK names vertical beside it), back says rev 0.6. Copper art: the bottom can rims are gone (the header pads reach the can bottom), the SPK top rim is shortened to clear the LS1 pads.
    - Router: `route2.py` now treats `placement.ART_KEEPOUTS` as a hard F.Cu track/via keepout (env `ART_KEEPOUT=1`, default); the first clean run put UART0_RX and VSYS through the copper key letters. Settings of the kept run: HIST_INC 30, CORR_R 7, GND_SUBSET extended with C2.2, C6.2, C12.2, C11.2 (they were boxed in when fanned out last); see `scripts/win/route.win.sh`. 80 iterations max, converged at 0 conflicts.
    - Windows toolchain: `scripts/win/` (env, route, finish). KiCad 10.0.6 Python for the pcbnew steps; scipy/shapely/gcc steps run in a podman container built from `scripts/win/Containerfile` (python 3.12 + numpy, scipy, shapely, svgelements, pillow). `render_sch.py` needs PyMuPDF, which is not installed: the schematic preview was rendered from the SVG export instead.
    - CPL: the new LCSC parts (J1, U3, U6, J5-J7, P1-P3, C22) have no entry in `jlc_footprints.json` (the EasyEDA API refused requests from here), so no rotation correction is applied for them; check them in the JLC preview (listed in `cpl_rotation_report.txt`).
17. **Hand re-route of the MCU area (2026-10-18, Benny, in KiCad, Freerouting session files `freerouting.dsn` left uncommitted).** The committed `.kicad_pcb` is Benny's edited board; `build/routes.json` is still the scripted item-16 route, so a regeneration from the scripts drops the hand routing. At the second commit (2026-10-18 17:46) `kicad-cli pcb drc --refill-zones` reported 26 unconnected items (144 at the first; board still being re-routed), and `../04-fab/` was generated from the item-16 board, not this one: regenerate the fab outputs once DRC is clean.
    - 2026-10-18 evening, scripted additions on Benny's board (pcbnew API, on top of his routing): 3x3 GND via grid (0.6/0.3) in U1's exposed pad, a 0.2 mm F.Cu track from U1 pin 19 (TESTEN) into the pad, 12 GND stitching vias from `island_stitch.py`, then 17 more GND vias + 2 short GND tracks (C9.2, C28.2) placed by a clearance search, including one via joining the split IRM_GND top pour. DRC went from 25 to 11 unconnected. Still open: **U1's exposed pad + pin 19 form a B.Cu GND island with no link to the main ground** (boxed in by +3V3, GPIO21/24, LED_R2/R3, RGB_CTRL tracks on B.Cu, island x 22.5-30.5 / y 47.6-55.1), GND pads of U3, C5, C1, three GND top-pour fragments, the loose +3V3/+1V1 pieces and SWCLK J2.21-U1.24.
    - 2026-10-18 22:19, Benny finished the routing: **DRC 0 errors, 0 unconnected** (2 silk-edge warnings + the KiCad 10 field notes), ERC 0/0. `../04-fab/` (gerbers, BOM, CPL, reports, renders) regenerated from this board. Review notes (kicad-happy + pin distances, straight line): Y1 is 8.5 mm from XIN (guide: keep the crystal close), the 1 uF VREG caps 5.5/5.9 mm and DVDD 50 / USB_VDD / ADC caps 5-7 mm from their pins, 27R 5.3-5.6 mm from the USB pins, C28 6.2 mm from USBLC6 VBUS; J3, R1, R2, R10, R16, C27, C28 are on the back now (bottom-side assembly, against the old top-side-only convention); 170 vias; kicad-happy EMC score 16/100 (37 for the scripted item-16 board).
19. **J3 battery connector -> JST B2B-PH-SM4-TB (C160352), 2026-10-29, user request.** Stock footprint `Connector_JST:JST_PH_B2B-PH-SM4-TB_1x02-1MP_P2.00mm_Vertical`; pin 1 = BAT_IN, pin 2 = GND unchanged. Edited **in place in Benny's hand-edited schematic** (J3 footprint, LCSC and description fields only; no regeneration) and in `design.py`. ERC 0/0. Benny removed SW5 and JP1 in the KiCad schematic, so J3 feeds Q1 directly (BAT_IN on Q1 pin 3, no BAT_SW net); the on-board BT1 holder tried on 2026-10-22 was not kept. `design.py`, `gen_sch.py`, `placement.py` and `silk.py` were brought in line the same day (`check_sch.py`: 313 pins, 78 nets, 0 problems against the KiCad schematic). The schematic file itself is Benny's KiCad version, not regenerated: its drawing differs from `gen_sch.py` output, so only regenerate if that is intended. PCB (same day, pcbnew script on Benny's board): J3 footprint swapped in place (same position, back side, rot 180; pads moved 1.26 mm but the 5.5 mm pads still meet the old tracks), MP tabs left without a net; SW5 and JP1 removed, their BAT_SW copper renamed BAT_IN, JP1's two pads replaced by a 0.5 mm B.Cu bridge, the 12 track segments that only ran to SW5's pads deleted. DRC with parity: 0 errors, 0 unconnected (2 silk-edge warnings). `../04-fab/` regenerated (gerbers, BOM, CPL, reports, schematic PDF, renders).
20. **Audio module -> IMU module (2026-10-29, user request).** Module 'AUDIO' renamed 'IMU' (nets AUM_* -> IMM_*, pours IMU_GND_TOP/BOT, badge net AUDIO_PWM -> IMU_INT1 on GPIO11). J4/R17/C21/C22 removed; U7 ST LSM6DS3TR-C (C967633, `Sensor_Motion:LSM6DS3` symbol, `Package_LGA:LGA-14_3x2.5mm_P0.5mm_LayoutBorder3x4y`) in I2C mode (CS = VDDIO, SA0 = GND -> 0x6A, SDx/SCx = GND, 10/11 NC), C30/C31 100 nF on VDD/VDDIO; P2 now carries 3V3/GND/SDA/SCL/INT1/INT2. Schematic regenerated from the scripts (they matched the KiCad schematic: all symbol positions identical before the change); `check_sch.py` 323 pins / 80 nets, 0 problems; ERC 0 errors, 2 warnings (`pin_to_pin`: U7's bidirectional SA0/SDx pins tied to IMM_GND, which carries a PWR_FLAG; harmless). PCB done on Benny's board with pcbnew scripts: audio parts and AUM copper removed, nets renamed, U7/C30/C31 placed (module-local (6.5, 7.5) / (2.6, 7.5) / (10.4, 7.5)), only the IMM_* nets routed (`NET_ONLY=IMM_ STITCH=0 FIXED_ROUTES=<the board's other copper>`; IMM_INT2 is 0.15 mm because U7 pad 9 sits 0.5 mm between two foreign pads), can silk updated (B2 · SHAKE SODA / 6-axis IMU). DRC with parity: 0 errors, 0 unconnected (2 silk-edge + 2 isolated-copper warnings). `../04-fab/` regenerated.
21. **Module SAO headers rotated (2026-10-29, user request).** P1-P3 now at rot 90 like the badge sockets J5-J7 (rows horizontal, pin 1 = bottom-left pad, silk triangle moved), module-local (6.5, 17.5), 1.1 mm higher so the pads stay 0.4 mm inside the can bottom. The turned header's courtyard took the speaker can's driver row, so Q2, D7, R20, R21, C25 moved to the BACK of the SPK can at the same x/y (`placement.MP` now takes an optional side). IR / IMU label bands moved up above the header; back-side module texts moved down to y 16-19.4. All module copper (IRM_/IMM_/SPM_) re-routed with `NET_ONLY=IRM_,IMM_,SPM_ STITCH=0 FIXED_ROUTES=<the rest of the board>` (150 tracks, 27 vias, 0 conflicts). Benny's J3 rotation (180 -> 0) and BAT_IN re-route saved in KiCad just before are kept. DRC with parity: 0 errors, 0 unconnected (silk + 1 isolated-copper warnings). `../04-fab/` regenerated.
22. **0.96" OLED connector J8 (2026-10-29, user request).** 1x4 2.54 mm SMD female socket HX PM2.54-1x4P TP-YQ (C42379197, staggered pins starting right -> `PinSocket_1x04_P2.54mm_Vertical_SMD_Pin1Right`; check pin 1 side against the part), pinout 1 GND, 2 3V3, 3 SCL, 4 SDA (the common SSD1306 module order) on I2C0 (SAO_SCL/SAO_SDA, pull-ups R22/R23). Schematic regenerated (327 pins / 80 nets, 0 problems; ERC 0 errors, the 2 known U7 warnings). PCB: Benny placed it (front, (14.5, 22.0), rot 90, just under the copper logo; `placement.py` updated). Routed locally with route2 on temporary nets (each J8 pad to a virtual pad on the nearest existing +3V3 / SAO_SCL / SAO_SDA track, the rest of the board fixed, `ART_KEEPOUT=0` because J8's top pad row lies inside the coarse logo keepout box; DRC confirms no contact with the logo copper): 10 tracks, 3 vias, GND pad 1 joins the top pour. DRC with parity: 0 errors, 0 unconnected (2 silk-edge warnings). `../04-fab/` regenerated.
23. **Module SAO headers to the back (2026-10-29, user request after review).** With P1–P3 on the can fronts the vertical headers only mated with the module face-down (IR dome, can art and transducer facing the badge). P1–P3 now sit on B.Cu at the same module-local (6.5, 17.5), rot 270 after the flip (`placement.HDR = (6.5, 17.5, 270, 'B')`): seen from the front pin 1 is the top-left pad, the same pad pattern as J5–J7, so a module plugs in face-up with its body extending up from the socket (over badge y ≈ 117–139, which covers the CREDIT LEDs D1–D5). Q2, D7, R20, R21, C25 went back to the front of the SPK can at the same x/y. Silk (`silk.py` and the board): pin-1 triangles moved to B.Silkscreen next to the back pin-1 pad (local y 14.97), back texts "Bn … MODULE / snap off, / plug into Jx" moved up to local y 3.6 / 5.4 / 7.0. Done with pcbnew scripts on Benny's board: module-net copper deleted, only IRM_/IMM_/SPM_ re-routed (`NET_ONLY=IRM_,IMM_,SPM_ STITCH=0 ROUTE_ITERS=40 FIXED_ROUTES=<the rest of the board>`, 147 tracks, 34 vias, 0 conflicts), zones refilled. DRC with parity: 0 errors, 0 unconnected (2 silk-edge warnings on J1). `../04-fab/` regenerated (BOM/CPL, gerbers, DRC report, renders; the CPL now has 13 bottom-side parts) and `order-spec.md` switched to two-sided SMT assembly. J8 footprint checked against the HX PM2.54-1x4P TP-YQ drawing (layout "B": leftmost leg in the upper row), matches.
24. **Module SAO headers turned 180° (2026-10-29, user request).** Item 23 made the modules cover the CREDIT LEDs D1–D5. P1–P3 stay on B.Cu but at rot 90 (`placement.HDR = (6.5, 17.5, 90, 'B')`): seen from the front pin 1 is now the bottom-right pad, so a module is turned 180° to plug in and hangs **down** from its socket, face-up, over badge y ≈ 130–152 (about 2 mm past the pedestal edge; it covers only TP1 of the flat test pads). The front can texts were then turned 180° (labels in place, IMU band lines swapped, side texts mirrored to the other edge; `silk.py` and the board) so they read upright when plugged in. The SPK can's vertical side texts became a horizontal label band like the other cans (lines at local y 15.4 / 17.1, "B3 · BEEP FIZZ" at 16.25, below the driver row). The back texts are turned 180° as well (line order reversed, same 3.6–7.0 band, middle line at 5.2). Stale badge-back texts removed: "SW5: optional (DNP)", "JP1: cut for SW5" (board only) and "battery lead → J3 (front, bottom)" (board and `silk.py`). Benny then removed the IR can's "38k" text and merged the tagline into one 3-line text "THE SECURITY SUMMIT / FOR RESEARCHERS / BY RESEARCHERS" at (39, 25) in KiCad; `silk.py` still draws the old versions. The re-route had left the IMU can's front IMM_GND pour as an unconnected island (removed by the fill, 8.6 mm² left); 11 IMM_GND stitching vias (0.6/0.3) at free spots bring it back to 199.5 mm². Back pin-1 triangles moved next to the new pin-1 pad (local (10.7, 20.03), pointing −x). Module nets re-routed the same way as item 23 (152 tracks, 33 vias, 0 conflicts). DRC with parity: 0 errors, 0 unconnected (2 silk-edge warnings on J1). `../04-fab/` regenerated.
15. **SAO connectors to SMT (2026-10-18, user request):** J5–J7 = HC-PM254-5.0H-2x3PS-02A (C42163131) on `PinSocket_2x03_P2.54mm_Vertical_SMD`, P1–P3 = PZ254-2-03-S (C3294461) on `PinHeader_2x03_P2.54mm_Vertical_SMD`. Schematic regenerated, `check_sch.py --erc` 0 problems / ERC 0. The SMD socket pads span ≈ 8 mm across the rows, so the rev 0.5 7 mm socket pitch (x 4.5 / 11.5 / 18.5) must grow at the re-layout; check both land patterns against the datasheets then. No THT parts remain in the BOM (J2 is DNP). Keyed option checked and not applied (no board-mount keyed female exists on LCSC/JLC), see `../00-bom/bom-deltas.md` rev 0.6b.
10. **rev 0.5 breakaway modules** (user decision 2026-10-11): U5/R19/C23/C24 → IR module, J4/R17/C21/C22 → audio module, new speaker module LS1/Q2/D7/R20/R21/C25 (BOM-B2 add-on 7). GPIO25 drives the speaker and stays on J2 pin 15. Sockets J5–J7 sit where U5 and J4 were (x 4.5 / 11.5 / 18.5, y 82.5–87.5, pins along y, pin 1 = GND at the top). Headers are THT: either JLC hand-solders them or they ship DNP. Modules stand upright when plugged in; right-angle headers (same pads) would make them lie flat.
11. **Vending-machine theme (2026-10-11, user request):** silkscreen in `silk.py`: shelf items A1–A4 (the RGB LEDs) with price tags over a dispensing coil, a keypad bezel with SELECT (the product window is notched around it), CREDIT meter with coin values, ITEM PICKUP door around the module slots (labelled B1 IR / B2 AUDIO / B3 SPK), a coin slot next to INSERT COIN, and service-panel texts on the back (SERVICE COMPARTMENT, model plate, NO REFUNDS · DO NOT TILT OR ROCK). The modules are the vended items: B1 "EYE CANDY" candy-bar wrapper (crimped silk edges, 1.2 mm chamfered corners), B2 "AUDIO POP" soda can (R 2.5 mm corners, fizz bubbles), B3 "BEEP CHIPS" chips bag (crimped edges, 2 mm chamfers). Corner styles live in `placement.MODULE_CORNERS`; `pcb_build.module_perimeter()` / `add_module_edges()` draw them. The router and the module pours still use the plain rectangles (the pours are clipped by the outline), so corner cuts must stay small and clear of copper — DRC copper-edge clearance catches a conflict. Placement, routing, netlist and BOM/CPL are unchanged; gerbers regenerated. Superseded in part by item 12 (modules are cans now).
12. **Outline rework + soda-can modules (2026-10-11, user request, second step):**
    - Main board: the R 6 rounded top became a **header sign box** x 7–49 × y 0–9 (R 2.5 top corners, R 1 shoulder fillets, R 2 cabinet corners at y 9–11). The lanyard holes moved into it: H1 (12, 5.5), H2 (44, 5.5), 3 mm web above the hole, "INTENT-O-MATIC" marquee between them. Logo moved down 1 mm (`art_logo.py ... 40 8 10`), tagline to y 23.3 / 25.1. Nothing else on the badge moved.
    - Modules are **cans 13 × 22 mm** (`placement.CAN_W/CAN_H/CAN_R`, all corners R 2.2) at x 5.5–18.5 / 21.5–34.5 / 37.5–50.5, tabs at x 12 / 28 / 44, 3 mm gaps between cans; blank 56 × 124. Parts re-placed inside (`placement.MP`): header at the can bottom (pin 2 on the centre line), IR dome / jack / transducer up top, passives in a row below. The jack lies across the AUDIO can, body 0.2 mm inside the left edge, barrel 1.8 mm into the gap toward the IR can (mouth −x, as in rev 0.5). Silk: rim lines, label band with a wave, "B1 · IR COLA / 38 kHz", "B2 · AUDIO POP / 3.5mm", "B3 · BEEP FIZZ"; back: "Bn <name> MODULE / snap off, / plug into Jx".
    - **Partial re-route** instead of a full router run: `router/prune_routes.py geo.json <old routes> routes_main.json` drops the module-net copper plus GND vias/tracks that no longer fit the outline or sit inside the lanyard pads' 1.5 mm clearance ring (8 stitching vias), then `FIXED_ROUTES=$W/routes_main.json NET_ONLY=IRM_,AUM_,SPM_ STITCH=0 ROUTE_ITERS=40 route2.py geo.json routes_mod.json` routes only the module nets with everything else fixed (97 tracks, 14 vias, 0 conflicts in 3 s), and `prune_routes.py --merge routes_main.json routes_mod.json routes.json` recombines. The rev 0.5 rectangular-module routes are kept as `build/routes_rev0.5_rect_modules.json`. Router grid is now `NY = 1270` (y to 125.9).
    - Result: 1305 tracks, 406 vias; DRC 0 violations, 0 unconnected (+ the 86 cosmetic KiCad 10 field notes); gerbers, CPL (module parts moved), renders regenerated.
13. **"Go crazy" art pass (2026-10-11, user request, third step; placement and signal routing untouched):**
    - Outline: **feet** under the cabinet corners, x 0–5.5 and 50.5–56, y 88–94.5 (R 1.5 outer / R 1 inner corners), separated from the pedestal by a 2.5 mm notch with R 0.8 fillets. Purely additive, the GND pour fills them.
    - **Exposed-copper art** (`scripts/art_copper.py`, called from `pcb_finish.py` before the zone fill): the INTENT logo (from `build/logo.json`, F.Cu polygons + F.Mask openings, replaces the white silk logo), the INTENT-O-MATIC marquee, the key letters A/B/C and BOOT as copper text with mask openings, and the can rims as mask openings over the module ground pours. Gold with ENIG, silver with the lead-free HASL in the order spec. The art regions (`placement.ART_KEEPOUTS`) were checked to be free of F.Cu signal tracks; `router/prune_routes.py --art` drops the GND stitching vias inside them (28 vias incl. the feet/edge ones), so routes.json now holds 1305 tracks / 378 vias. **Re-check the keepouts after any re-route** (a signal track under copper art would short to it).
    - Silk: product icons around the four shelf LEDs (can, cup with straw, chips bag, candy bar — the WS2812 glows inside), a glass glare in the lower-left pane, a coin by INSERT COIN, pull-tab rings on the can stubs (the 2 × 4 mm tab that stays on the can after snapping). Back: the three AAA cells drawn where they sit inside the compartment (+ / − ends), a DANGER 3V3 INSIDE triangle sticker and a SERVICE LOG with ruled lines in the strip beside the compartment.
    - DRC 0 violations, 0 unconnected; gerbers (F.Mask now carries the art openings), renders, reports regenerated. Open: order ENIG if the gold look matters (see `../04-fab/order-spec.md`).
1. **R11/R12 27 Ω = C25100.** The C25105 in bom-deltas is 33 Ω.
2. **U5 IR pinout corrected:** 1, 2 = GND, 3 = OUT, 4 = VCC. The spec text had OUT on pin 1.
3. **J4 PJ-320D (C431535) is an SMD part.** Pads: 1 = S, 2 = R2, 3 = R1, 4 = T (same geometry as KiCad's PJ320D). Tip + R1 = audio, S + R2 = GND.
4. **Keypad GPIOs swapped for routing:** A = GPIO4 (SW2, top), B = GPIO3, C = GPIO2 (SW4, bottom). Firmware only. The gpio-map is updated.
5. **J3 battery connector is on the front pedestal** (20, 95), so assembly stays top-side only (user decision). SW5 (DNP) and JP1 (bridged jumper) are on the back pedestal.
6. U1 rotated 180° and flash U2 rotated 270° under U1. Several decaps sit 2–5 mm from their pins (corners of the QFN) instead of ≤ 1 mm. That is acceptable for RP2040.
7. U1 exposed pad: 9 × 0.3 mm vias in the pad. These are not tented on the pad side, which is usual for QFN thermal vias.
8. USB D+/D− are routed as 0.2 mm tracks. A 90 Ω pair is not achievable on 1.6 mm 2-layer FR-4 at a reasonable width. Full-speed USB (12 Mbit/s) does not need it.
9. Silkscreen reference designators are moved to the Fab layer (not printed). The art follows `02-layout`. Glyphs that the KiCad font lacks (★ ♪) are replaced with plain text.

## Schematic rework notes (2026-10-11)
- Verified with `scripts/check_sch.py --erc`: 259 pins, 68 nets, 0 mismatches against design.py; ERC 0 errors.
- The one ERC warning (`lib_symbol_mismatch` on J1) is deliberate: the KiCad 10 library renamed the USB-C shield pin from `S1` to `SH`; `schlib.PIN_RENAMES` maps it back so the symbol still matches the custom footprint pad `S1` and the PCB.
- PCB DRC with schematic parity after the rework: 0 errors, 0 unconnected. Under KiCad 10 it also lists 74 `footprint_symbol_field_mismatch` warnings (Description field empty on the PCB footprints); cosmetic, not present under KiCad 9.
- One intentional wire crossing in the USB block (D− drops past the D+ run at (78.74, 101.6)); crossings without a junction dot are not connections.

## Still to verify (cannot be done from here)
- **JLC preview after upload:** rotation of D1–D5 (assumes LCSC pad 1 = cathode, CPL uses 180°), Q1/Q2/U3 (180°), U2 (180°), U4 (270°). **Also D6, D7, U5, LS1**: symmetric pad patterns, the fitter cannot detect a 180° error (D6 reversed = no USB power; U5 reversed puts VCC on a GND pad; D7 reversed shorts the collector drive through the diode; LS1 is tolerant by footprint design). See `../04-fab/cpl_rotation_report.txt`.
- **JLC DFM on the breakaway features:** 0.5 mm NPTH mouse bites centred on the edge line, 2 mm routed gap, 4 mm tabs. If JLC objects to the half-holes on the edge, move the MB footprints 0.25 mm into the tab (`pcb_build.add_mousebites`).
- 1N4148W C81598 showed 300 pieces in LCSC stock on 2026-10-11; check JLC's own stock or substitute.
- The 12 MHz crystal C133334 is specified for CL = 20 pF, but C11/C12 are 15 pF (Pico values). Expect about +50 ppm, which is fine for USB. If you want it exact, use 27–33 pF caps.
- 3D view: the custom footprints and three stock ones whose STEP files are missing in KiCad 10 (TS-1187A, WS2812B-2020, MSK12C02) use simplified box/cylinder VRML models from `scripts/gen_3d.py` (`intent.3dshapes/`). Cosmetic only; dimensions follow the datasheets.
