MichaelMIL/intent2026/04-fab/archive-rev0.5/intent-2026-badge-schematic.pdf

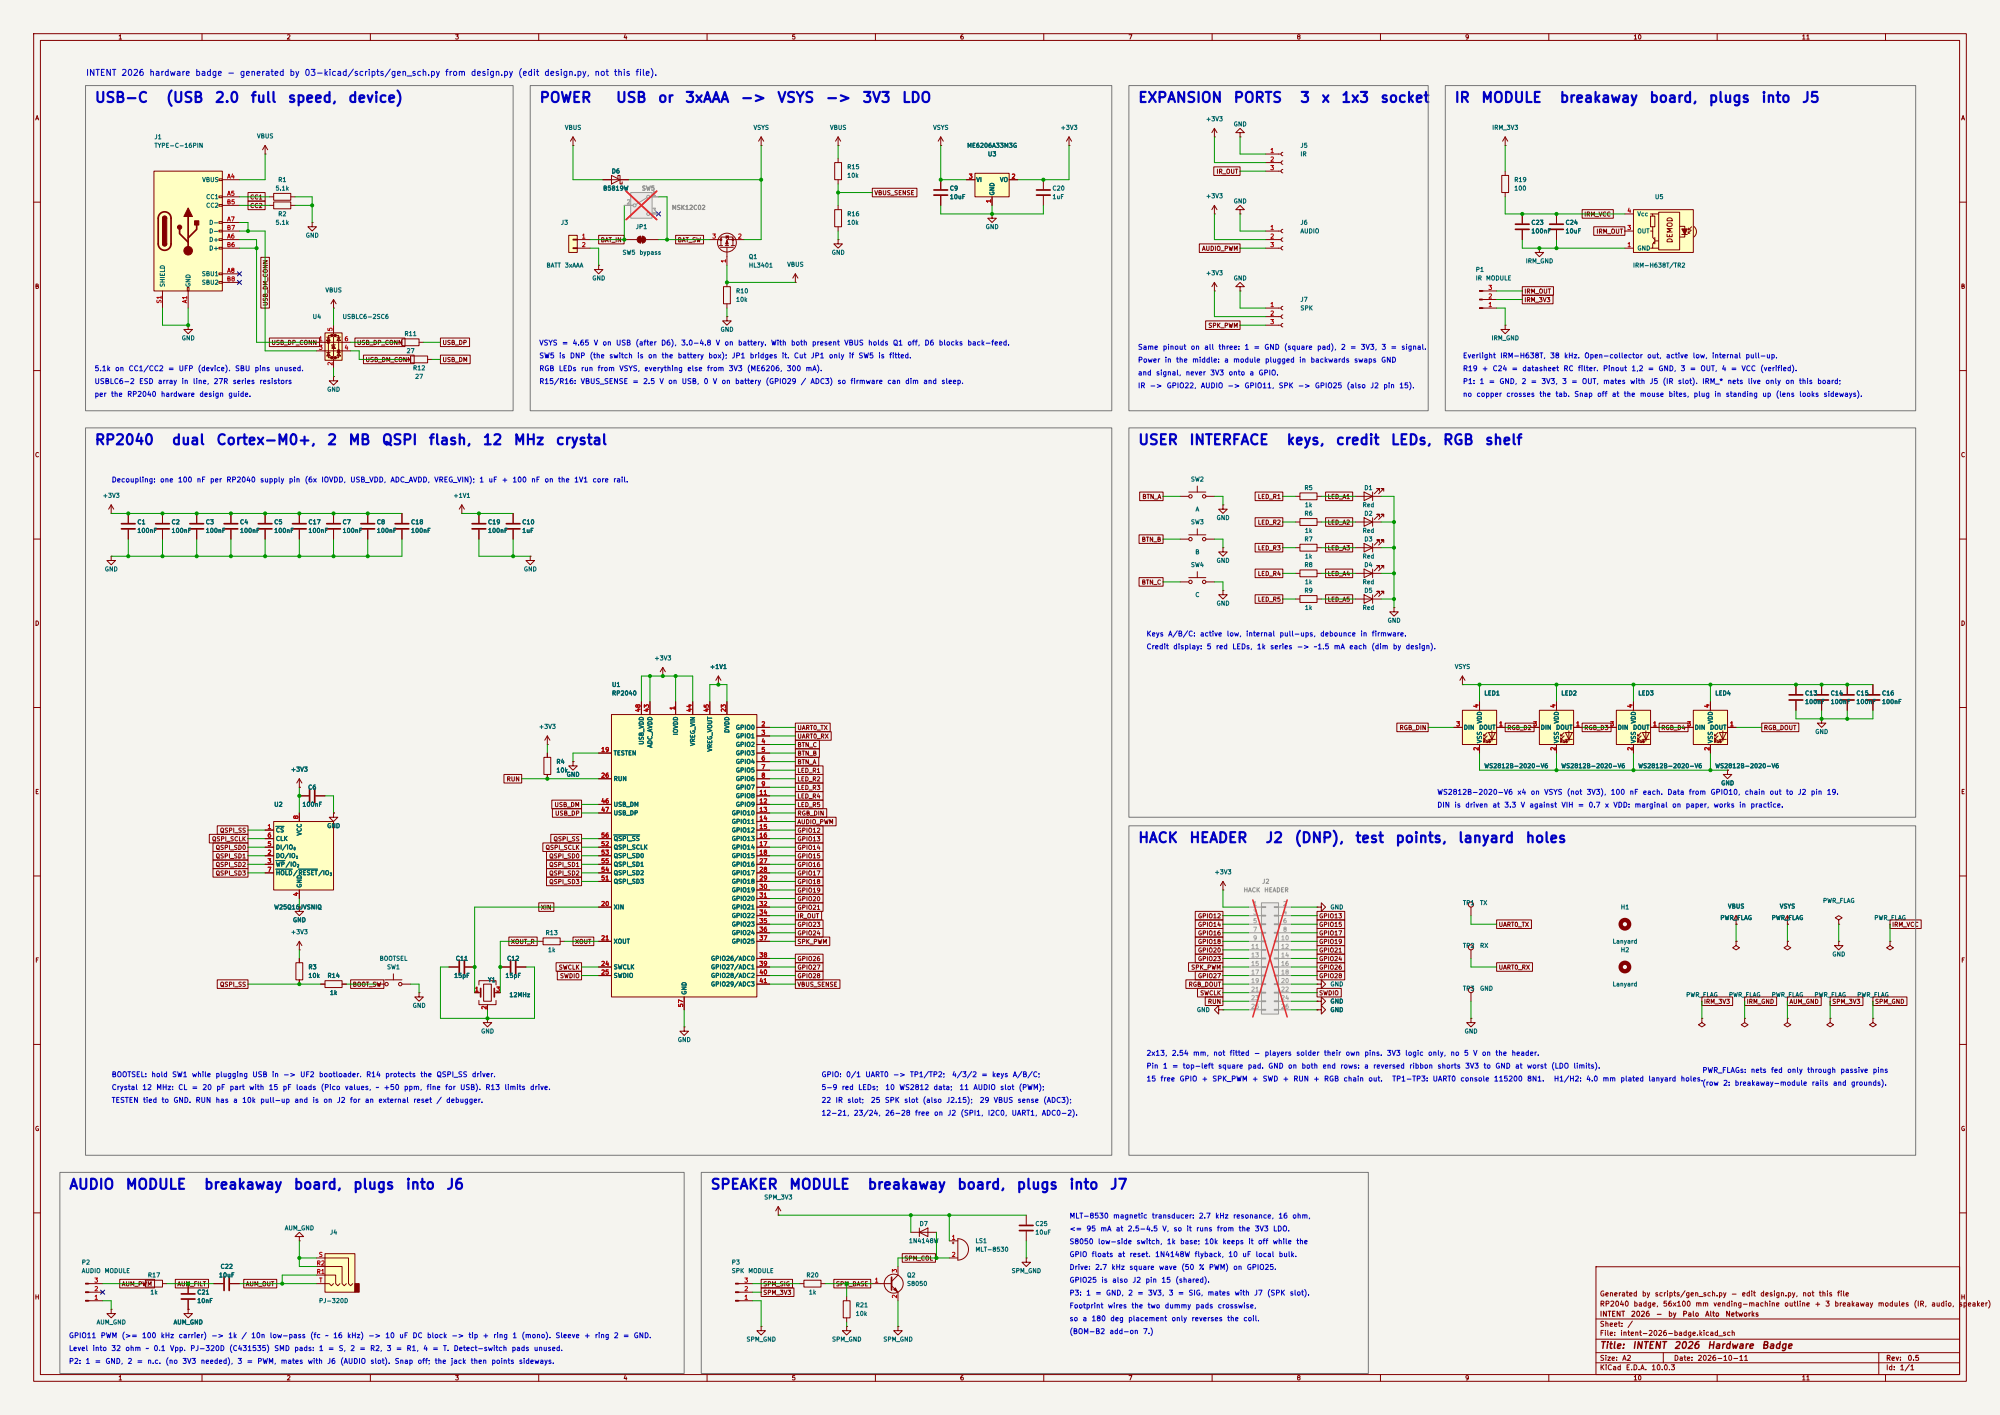
[picture p5: page 1]
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

IR MODULE breakaway board, plugs into J5

VSYS = 4.65 V on USB (after D6), 3.0-4.8 V on battery. With both present VBUS holds Q1 off, D6 blocks back-feed.
SW5 is DNP (the switch is on the battery box); JP1 bridges it. Cut JP1 only if SW5 is fitted.
RGB LEDs run from VSYS, everything else from 3V3 (ME6206, 300 mA).
R15/R16: VBUS_SENSE = 2.5 V on USB, 0 V on battery (GPIO29 / ADC3) so firmware can dim and sleep.

Same pinout on all three: 1 = GND (square pad), 2 = 3V3, 3 = signal.
Power in the middle: a module plugged in backwards swaps GND
and signal, never 3V3 onto a GPIO.
IR -> GPIO22, AUDIO -> GPIO11, SPK -> GPIO25 (also J2 pin 15).

Everlight IRM-H638T, 38 kHz. Open-collector out, active low, internal pull-up.
R19 + C24 = datasheet RC filter. Pinout 1,2 = GND, 3 = OUT, 4 = VCC (verified).
P1: 1 = GND, 2 = 3V3, 3 = OUT, mates with J5 (IR slot). IRM_* nets live only on this board;
no copper crosses the tab. Snap off at the mouse bites, plug in standing up (lens looks sideways).

5.1k on CC1/CC2 = UFP (device). SBU pins unused.
USBLC6-2 ESD array in line, 27R series resistors
per the RP2040 hardware design guide.

RP2040 dual Cortex-M0+, 2 MB QSPI flash, 12 MHz crystal

USER INTERFACE keys, credit LEDs, RGB shelf

Decoupling: one 100 nF per RP2040 supply pin (6x IOVDD, USB_VDD, ADC_AVDD, VREG_VIN); 1 uF + 100 nF on the 1V1 core rail.

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

WS2812B-2020-V6 x4 on VSYS (not 3V3), 100 nF each. Data from GPIO10, chain out to J2 pin 19.
DIN is driven at 3.3 V against VIH = 0.7 x VDD: marginal on paper, works in practice.

4 DI/IO0 5 CLK 6 HOLD/RESET/IO3 7 VCC

HACK HEADER J2 (DNP), test points, lanyard holes

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

PWR_FLAGs: nets fed only through passive pins

BOOTSEL: hold SW1 while plugging USB in -> UF2 bootloader. R14 protects the QSPI_SS driver.
Crystal 12 MHz: CL = 20 pF part with 15 pF loads (Pico values, ~ +50 ppm, fine for USB). R13 limits drive.
TESTEN tied to GND. RUN has a 10k pull-up and is on J2 for an external reset / debugger.

5-9 red LEDs; 10 WS2812 data; 11 AUDIO slot (PWM);
22 IR slot; 25 SPK slot (also J2.15); 29 VBUS sense (ADC3);
12-21, 23/24, 26-28 free on J2 (SPI1, I2C0, UART1, ADC0-2).

AUDIO MODULE breakaway board, plugs into J6

SPEAKER MODULE breakaway board, plugs into J7

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

S8050 low-side switch, 1k base; 10k keeps it off while the
GPIO floats at reset. 1N4148W flyback, 10 uF local bulk.
Drive: 2.7 kHz square wave (50 % PWM) on GPIO25.
GPIO25 is also J2 pin 15 (shared).
P3: 1 = GND, 2 = 3V3, 3 = SIG, mates with J7 (SPK slot).
Footprint wires the two dummy pads crosswise, so a 180 deg placement only reverses the coil.

Generated by scripts/gen_sch.py - edit design.py, not this file
RP2040 badge, 56x100 mm vending-machine outline + 3 breakaway modules (IR, audio, speaker)
INTENT 2026 - by Palo Alto Networks
Sheet: /
File: intent-2026-badge.kicad_sch
Title: INTENT 2026 Hardware Badge

GPIO11 PWM (>= 100 kHz carrier) -> 1k / 10n low-pass (fc ~ 16 kHz) -> 10 uF DC block -> tip + ring 1 (mono). Sleeve + ring 2 = GND.
Level into 32 ohm ~ 0.1 Vpp. PJ-320D (C431535) SMD pads: 1 = S, 2 = R2, 3 = R1, 4 = T. Detect-switch pads unused.
P2: 1 = GND, 2 = n.c. (no 3V3 needed), 3 = PWM, mates with J6 (AUDIO slot). Snap off; the jack then points sideways.

Size: A2 | Rev: 0.5
KiCad E.D.A. 10.0.3 | Id: 1/1
