MichaelMIL/intent2026/03-kicad/intent-2026-badge.kicad_pcb

## KiCad design 03-kicad/intent-2026-badge.kicad_pcb (2026-10-29)

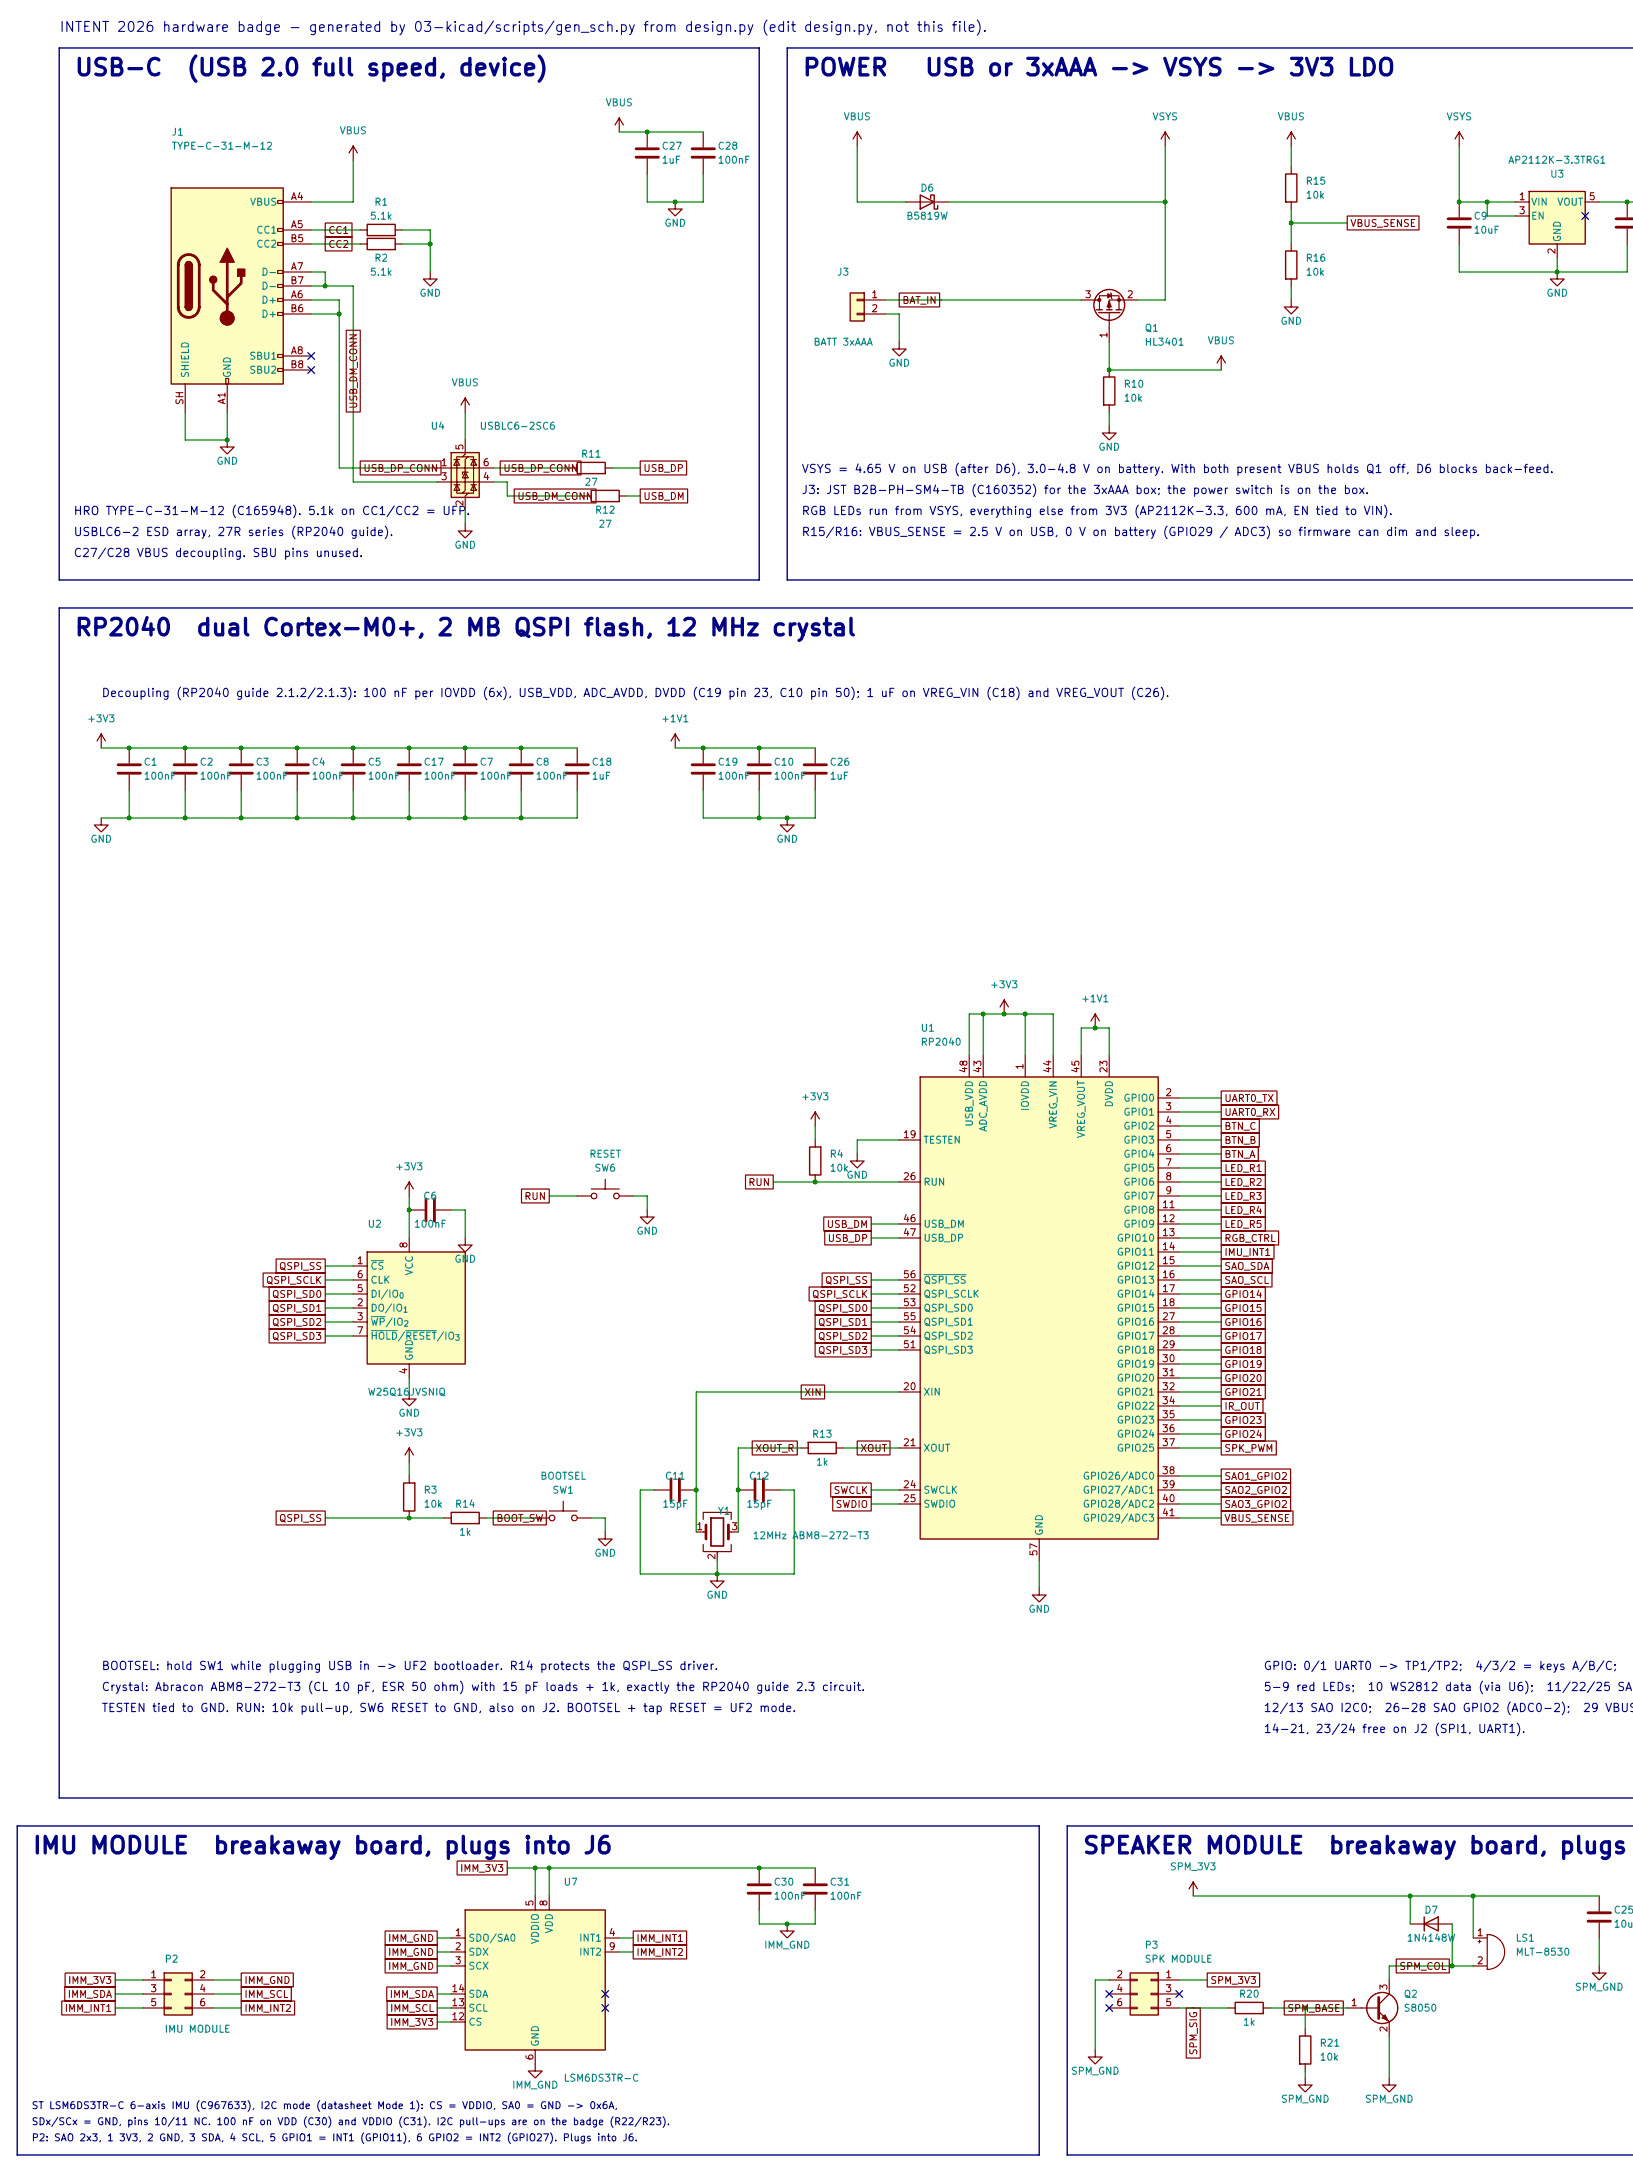
[picture p6: schematic intent-2026-badge.kicad_sch, INTENT 2026 Hardware Badge, part in row 1, column 1]

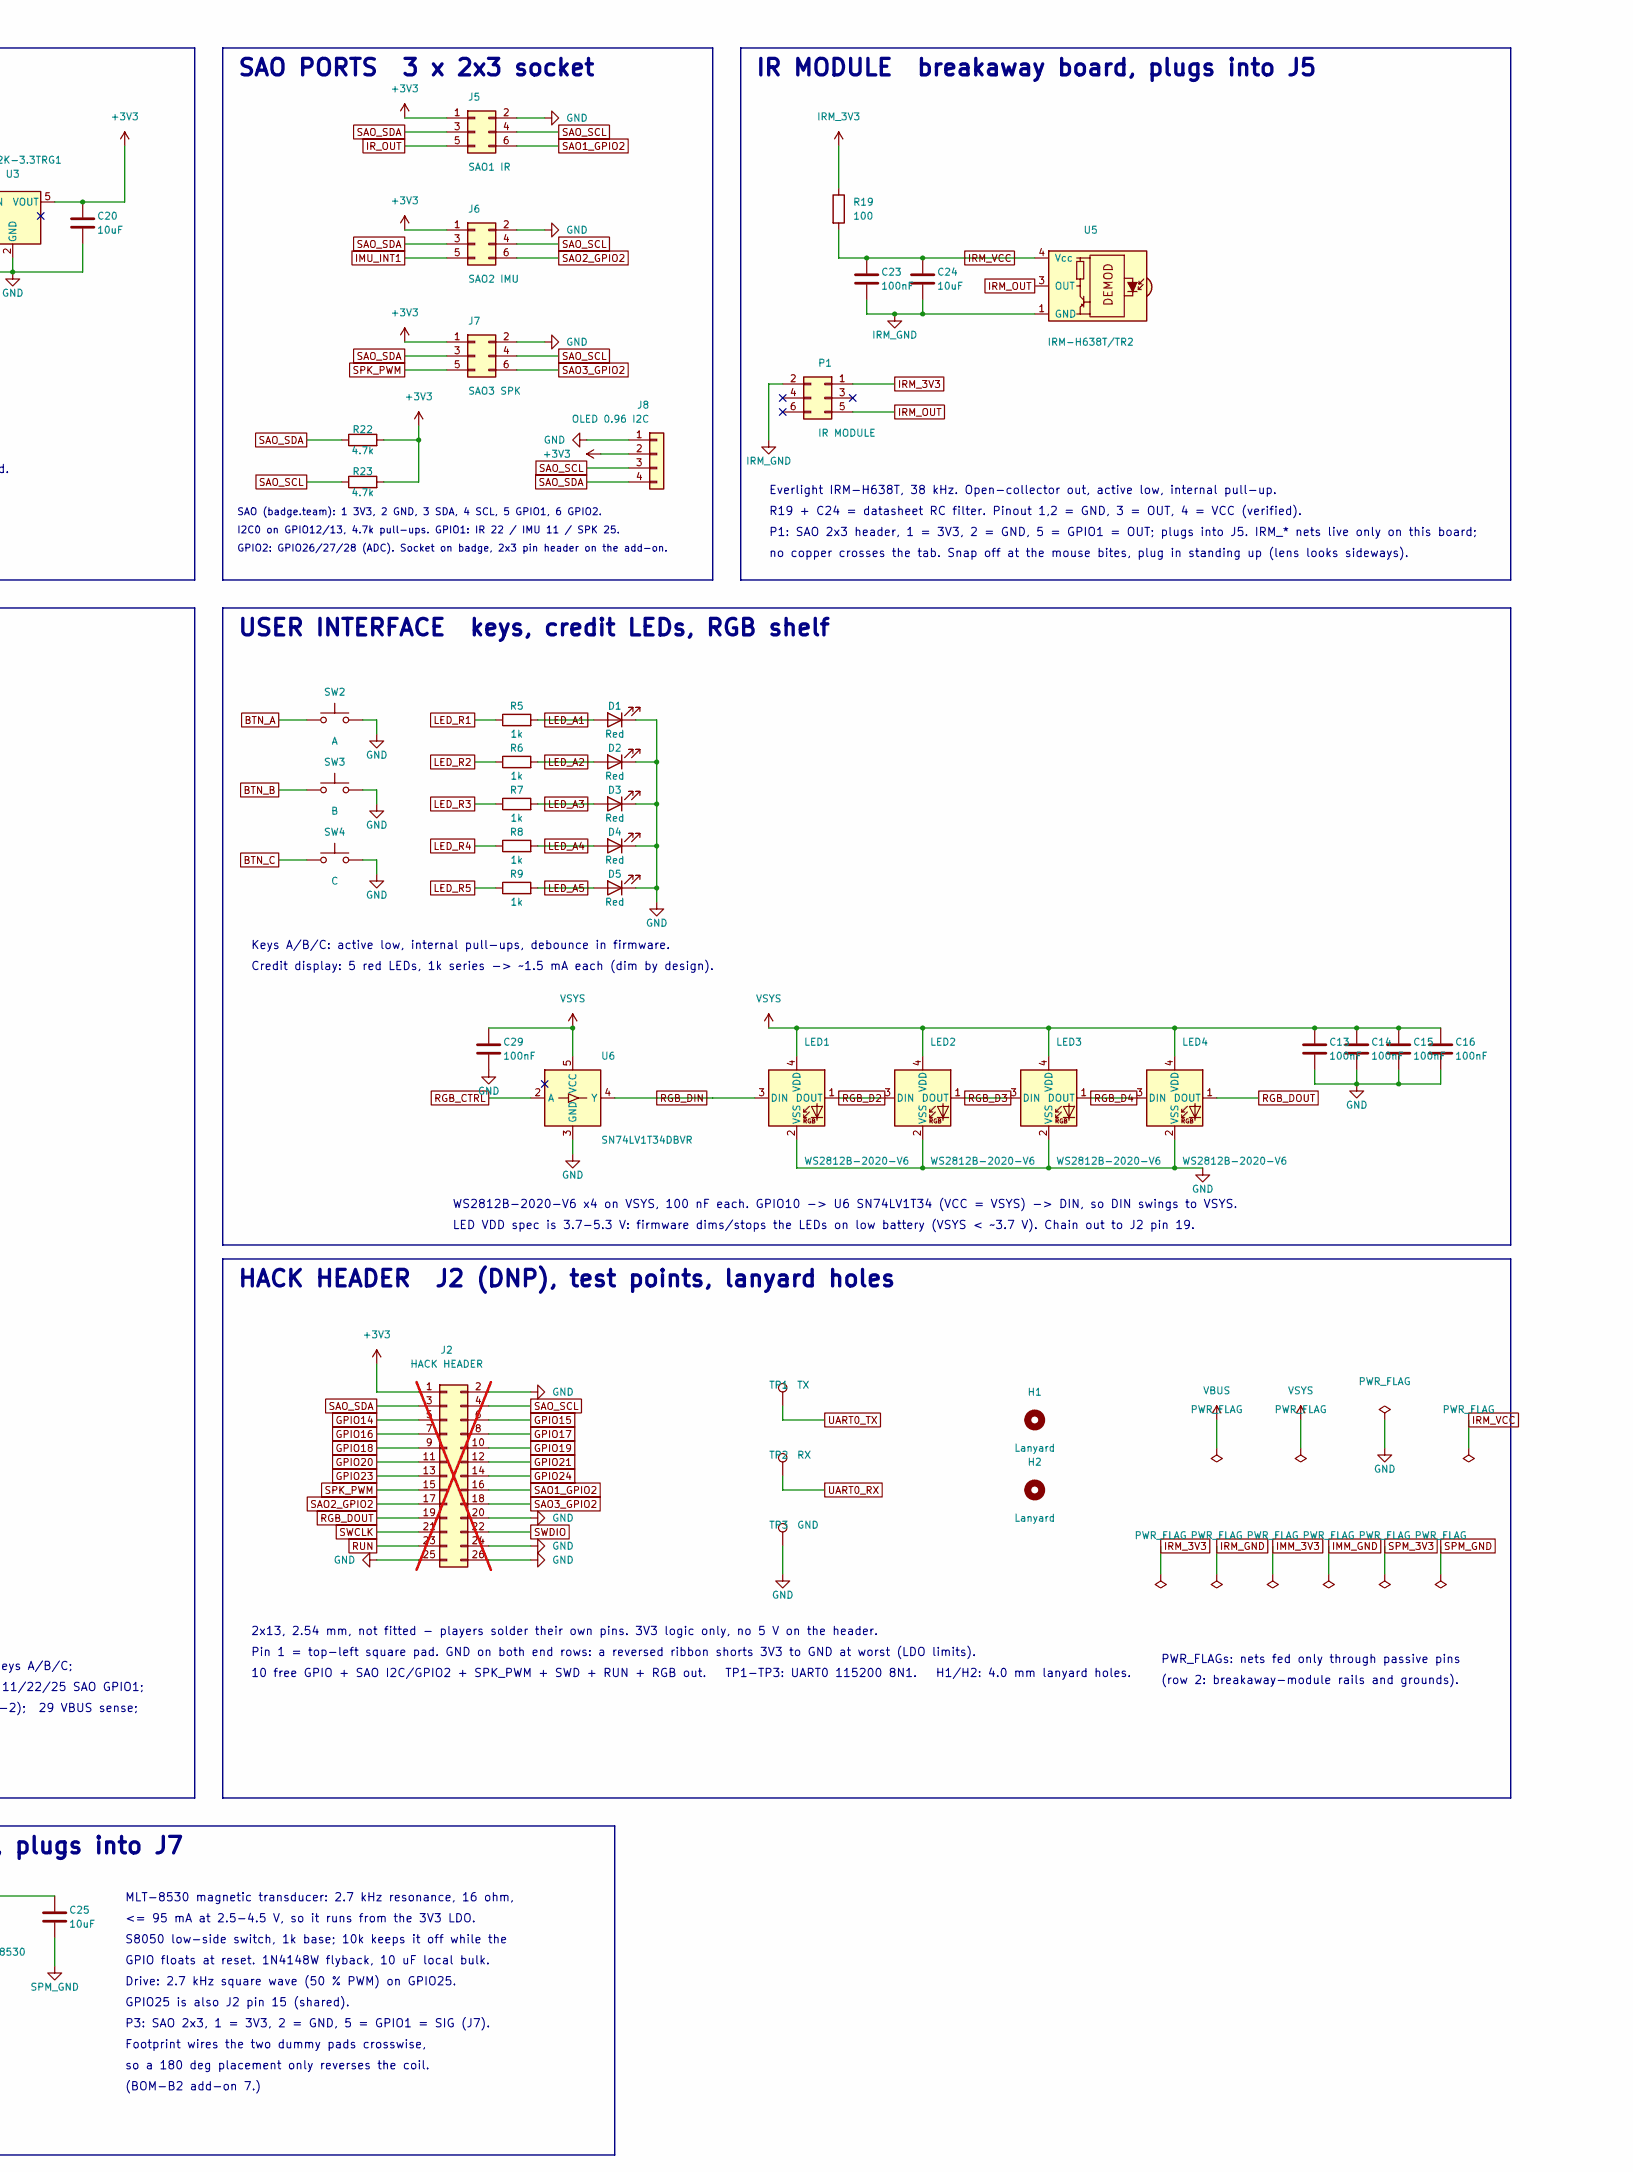
[picture p7: schematic intent-2026-badge.kicad_sch, INTENT 2026 Hardware Badge, part in row 1, column 2]

Parts:
C1, C2, C3, C4, C5, C6, C7, C8, C10, C13, C14, C15, C16, C17, C19, C23, C28, C29, C30, C31: 100nF; C_0402_1005Metric; LCSC C60474
C9, C20, C24, C25: 10uF; C_0805_2012Metric; LCSC C7503495
C11, C12: 15pF; C_0402_1005Metric; LCSC C1548
C18, C26, C27: 1uF; C_0402_1005Metric; LCSC C6119792
D1, D2, D3, D4, D5: Red; LED_0603_1608Metric; LCSC C2286
D6: B5819W; D_SOD-123; LCSC C7420330
D7: 1N4148W; D_SOD-123; LCSC C81598
H1, H2: Lanyard; LanyardHole_4.0mm_Plated
J1: TYPE-C-31-M-12; USB_C_Receptacle_HRO_TYPE-C-31-M-12; LCSC C165948
J2: HACK HEADER; PinHeader_2x13_P2.54mm_Vertical; not fitted
J3: BATT 3xAAA; JST_PH_B2B-PH-SM4-TB_1x02-1MP_P2.00mm_Vertical; LCSC C160352
J5: SAO1 IR; PinSocket_2x03_P2.54mm_Vertical_SMD; LCSC C42163131
J6: SAO2 IMU; PinSocket_2x03_P2.54mm_Vertical_SMD; LCSC C42163131
J7: SAO3 SPK; PinSocket_2x03_P2.54mm_Vertical_SMD; LCSC C42163131
J8: OLED 0.96 I2C; PinSocket_1x04_P2.54mm_Vertical_SMD_Pin1Right; LCSC C42379197
LED1, LED2, LED3, LED4: WS2812B-2020-V6; LED_WS2812B-2020_PLCC4_2.0x2.0mm; LCSC C52917434
LS1: MLT-8530; Buzzer_MLT-8530_C94599; LCSC C94599
P1: IR MODULE; PinHeader_2x03_P2.54mm_Vertical_SMD; LCSC C3294461
P2: IMU MODULE; PinHeader_2x03_P2.54mm_Vertical_SMD; LCSC C3294461
P3: SPK MODULE; PinHeader_2x03_P2.54mm_Vertical_SMD; LCSC C3294461
Q1: HL3401; SOT-23; LCSC C22469449
Q2: S8050; SOT-23; LCSC C2146
R1, R2: 5.1k; R_0402_1005Metric; LCSC C25905
R3, R4, R10, R15, R16, R21: 10k; R_0402_1005Metric; LCSC C25744
R5, R6, R7, R8, R9, R13, R14, R20: 1k; R_0402_1005Metric; LCSC C11702
R11, R12: 27; R_0402_1005Metric; LCSC C25100
R19: 100; R_0402_1005Metric; LCSC C25076
R22, R23: 4.7k; R_0402_1005Metric; LCSC C25900
SW1: BOOTSEL; SW_Push_1P1T_XKB_TS-1187A; LCSC C318884
SW2: A; SW_Push_1P1T_XKB_TS-1187A; LCSC C318884
SW3: B; SW_Push_1P1T_XKB_TS-1187A; LCSC C318884
SW4: C; SW_Push_1P1T_XKB_TS-1187A; LCSC C318884
SW6: RESET; SW_Push_1P1T_XKB_TS-1187A; LCSC C318884
TP1: TX; TestPoint_THTPad_D1.5mm_Drill0.7mm
TP2: RX; TestPoint_THTPad_D1.5mm_Drill0.7mm
TP3: GND; TestPoint_THTPad_D1.5mm_Drill0.7mm
U1: RP2040; QFN-56-1EP_7x7mm_P0.4mm_EP3.2x3.2mm; LCSC C2040
U2: W25Q16JVSNIQ; SOIC-8_3.9x4.9mm_P1.27mm; LCSC C2456211
U3: AP2112K-3.3TRG1; SOT-23-5; LCSC C51118
U4: USBLC6-2SC6; SOT-23-6; LCSC C2827654
U5: IRM-H638T/TR2; IRM-H638T_C91447; LCSC C91447
U6: SN74LV1T34DBVR; SOT-23-5; LCSC C100024
U7: LSM6DS3TR-C; LGA-14_3x2.5mm_P0.5mm_LayoutBorder3x4y; LCSC C967633
Y1: 12MHz ABM8-272-T3; Crystal_SMD_3225-4Pin_3.2x2.5mm; LCSC C20625731

Connections:
+1V1: C10.1, C19.1, C26.1, U1.23 (DVDD), U1.45 (VREG_VOUT), U1.50 (DVDD)
+3V3: C1.1, C2.1, C3.1, C4.1, C5.1, C6.1, C7.1, C8.1, C17.1, C18.1, C20.1, J2.1, J5.1, J6.1, J7.1, J8.2, R3.2, R4.2, R22.2, R23.2, U1.1 (IOVDD), U1.10 (IOVDD), U1.22 (IOVDD), U1.33 (IOVDD), U1.42 (IOVDD), U1.43 (ADC_AVDD), U1.44 (VREG_VIN), U1.48 (USB_VDD), U1.49 (IOVDD), U2.8 (VCC), U3.5 (VOUT)
BAT_IN: J3.1, Q1.3 (D)
BOOT_SW: R14.2, SW1.1
BTN_A: SW2.1, U1.6 (GPIO4)
BTN_B: SW3.1, U1.5 (GPIO3)
BTN_C: SW4.1, U1.4 (GPIO2)
CC1: J1.A5 (CC1), R1.1
CC2: J1.B5 (CC2), R2.1
GND: C1.2, C2.2, C3.2, C4.2, C5.2, C6.2, C7.2, C8.2, C9.2, C10.2, C11.2, C12.2, C13.2, C14.2, C15.2, C16.2, C17.2, C18.2, C19.2, C20.2, C26.2, C27.2, C28.2, C29.2, D1.1 (K), D2.1 (K), D3.1 (K), D4.1 (K), D5.1 (K), J1.A1 (GND), J1.A12 (GND), J1.B1 (GND), J1.B12 (GND), J1.SH (SHIELD), J2.2, J2.20, J2.24, J2.25, J2.26, J3.2, J5.2, J6.2, J7.2, J8.1, LED1.2 (VSS), LED2.2 (VSS), LED3.2 (VSS), LED4.2 (VSS), R1.2, R2.2, R10.2, R16.2, SW1.2, SW2.2, SW3.2, SW4.2, SW6.2, TP3.1 (1_1), U1.19 (TESTEN), U1.57 (GND), U2.4 (GND), U3.2 (GND), U4.2 (GND), U6.3 (GND), Y1.2 (G), Y1.4 (G)
GPIO14: J2.5, U1.17 (GPIO14)
GPIO15: J2.6, U1.18 (GPIO15)
GPIO16: J2.7, U1.27 (GPIO16)
GPIO17: J2.8, U1.28 (GPIO17)
GPIO18: J2.9, U1.29 (GPIO18)
GPIO19: J2.10, U1.30 (GPIO19)
GPIO20: J2.11, U1.31 (GPIO20)
GPIO21: J2.12, U1.32 (GPIO21)
GPIO23: J2.13, U1.35 (GPIO23)
GPIO24: J2.14, U1.36 (GPIO24)
IMM_3V3: C30.1, C31.1, P2.1, U7.5 (VDDIO), U7.8 (VDD), U7.12 (CS)
IMM_GND: C30.2, C31.2, P2.2, U7.1 (SDO/SA0), U7.2 (SDX), U7.3 (SCX), U7.6 (GND), U7.7 (GND)
IMM_INT1: P2.5, U7.4 (INT1)
IMM_INT2: P2.6, U7.9 (INT2)
IMM_SCL: P2.4, U7.13 (SCL)
IMM_SDA: P2.3, U7.14 (SDA)
IMU_INT1: J6.5, U1.14 (GPIO11)
IRM_3V3: P1.1, R19.1
IRM_GND: C23.2, C24.2, P1.2, U5.1 (GND), U5.2 (GND)
IRM_OUT: P1.5, U5.3 (OUT)
IRM_VCC: C23.1, C24.1, R19.2, U5.4 (Vcc)
IR_OUT: J5.5, U1.34 (GPIO22)
LED_A1: D1.2 (A), R5.2
LED_A2: D2.2 (A), R6.2
LED_A3: D3.2 (A), R7.2
LED_A4: D4.2 (A), R8.2
LED_A5: D5.2 (A), R9.2
LED_R1: R5.1, U1.7 (GPIO5)
LED_R2: R6.1, U1.8 (GPIO6)
LED_R3: R7.1, U1.9 (GPIO7)
LED_R4: R8.1, U1.11 (GPIO8)
LED_R5: R9.1, U1.12 (GPIO9)
QSPI_SCLK: U1.52 (QSPI_SCLK), U2.6 (CLK)
QSPI_SD0: U1.53 (QSPI_SD0), U2.5 (DI/IO_{0})
QSPI_SD1: U1.55 (QSPI_SD1), U2.2 (DO/IO_{1})
QSPI_SD2: U1.54 (QSPI_SD2), U2.3 (~WP/IO_{2})
QSPI_SD3: U1.51 (QSPI_SD3), U2.7 (~HOLD/~RESET/IO_{3})
QSPI_SS: R3.1, R14.1, U1.56 (~QSPI_SS), U2.1 (~CS)
RGB_CTRL: U1.13 (GPIO10), U6.2 (A)
RGB_D2: LED1.1 (DOUT), LED2.3 (DIN)
RGB_D3: LED2.1 (DOUT), LED3.3 (DIN)
RGB_D4: LED3.1 (DOUT), LED4.3 (DIN)
RGB_DIN: LED1.3 (DIN), U6.4 (Y)
RGB_DOUT: J2.19, LED4.1 (DOUT)
RUN: J2.23, R4.1, SW6.1, U1.26 (RUN)
SAO1_GPIO2: J2.16, J5.6, U1.38 (GPIO26/ADC0)
SAO2_GPIO2: J2.17, J6.6, U1.39 (GPIO27/ADC1)
SAO3_GPIO2: J2.18, J7.6, U1.40 (GPIO28/ADC2)
SAO_SCL: J2.4, J5.4, J6.4, J7.4, J8.3, R23.1, U1.16 (GPIO13)
SAO_SDA: J2.3, J5.3, J6.3, J7.3, J8.4, R22.1, U1.15 (GPIO12)
SPK_PWM: J2.15, J7.5, U1.37 (GPIO25)
SPM_3V3: C25.1, D7.1 (K), LS1.1 (+), P3.1
SPM_BASE: Q2.1 (B), R20.2, R21.1
SPM_COL: D7.2 (A), LS1.2 (-), Q2.3 (C)
SPM_GND: C25.2, P3.2, Q2.2 (E), R21.2
SPM_SIG: P3.5, R20.1
SWCLK: J2.21, U1.24 (SWCLK)
SWDIO: J2.22, U1.25 (SWDIO)
UART0_RX: TP2.1 (1_1), U1.3 (GPIO1)
UART0_TX: TP1.1 (1_1), U1.2 (GPIO0)
USB_DM: R12.2, U1.46 (USB_DM)
USB_DM_CONN: J1.A7 (D-), J1.B7 (D-), R12.1, U4.3 (I/O2), U4.4 (I/O2)
USB_DP: R11.2, U1.47 (USB_DP)
USB_DP_CONN: J1.A6 (D+), J1.B6 (D+), R11.1, U4.1 (I/O1), U4.6 (I/O1)
VBUS: C27.1, C28.1, D6.2 (A), J1.A4 (VBUS), J1.A9 (VBUS), J1.B4 (VBUS), J1.B9 (VBUS), Q1.1 (G), R10.1, R15.1, U4.5 (VBUS)
VBUS_SENSE: R15.2, R16.1, U1.41 (GPIO29/ADC3)
VSYS: C9.1, C13.1, C14.1, C15.1, C16.1, C29.1, D6.1 (K), LED1.4 (VDD), LED2.4 (VDD), LED3.4 (VDD), LED4.4 (VDD), Q1.2 (S), U3.1 (VIN), U3.3 (EN), U6.5 (VCC)
XIN: C11.1, U1.20 (XIN), Y1.1
XOUT: R13.1, U1.21 (XOUT)
XOUT_R: C12.1, R13.2, Y1.3

Notes on the sheet:
USB-C (USB 2.0 full speed, device)
HRO TYPE-C-31-M-12 (C165948). 5.1k on CC1/CC2 = UFP.
USBLC6-2 ESD array, 27R series (RP2040 guide).
C27/C28 VBUS decoupling. SBU pins unused.
POWER USB or 3xAAA -> VSYS -> 3V3 LDO
VSYS = 4.65 V on USB (after D6), 3.0-4.8 V on battery. With both present VBUS holds Q1 off, D6 blocks back-feed.
J3: JST B2B-PH-SM4-TB (C160352) for the 3xAAA box; the power switch is on the box.
RGB LEDs run from VSYS, everything else from 3V3 (AP2112K-3.3, 600 mA, EN tied to VIN).
R15/R16: VBUS_SENSE = 2.5 V on USB, 0 V on battery (GPIO29 / ADC3) so firmware can dim and sleep.
SAO PORTS 3 x 2x3 socket
SAO (badge.team): 1 3V3, 2 GND, 3 SDA, 4 SCL, 5 GPIO1, 6 GPIO2.
I2C0 on GPIO12/13, 4.7k pull-ups. GPIO1: IR 22 / IMU 11 / SPK 25.
GPIO2: GPIO26/27/28 (ADC). Socket on badge, 2x3 pin header on the add-on.
IR MODULE breakaway board, plugs into J5
Everlight IRM-H638T, 38 kHz. Open-collector out, active low, internal pull-up.
R19 + C24 = datasheet RC filter. Pinout 1,2 = GND, 3 = OUT, 4 = VCC (verified).
P1: SAO 2x3 header, 1 = 3V3, 2 = GND, 5 = GPIO1 = OUT; plugs into J5. IRM_* nets live only on this board;
no copper crosses the tab. Snap off at the mouse bites, plug in standing up (lens looks sideways).
RP2040 dual Cortex-M0+, 2 MB QSPI flash, 12 MHz crystal
Decoupling (RP2040 guide 2.1.2/2.1.3): 100 nF per IOVDD (6x), USB_VDD, ADC_AVDD, DVDD (C19 pin 23, C10 pin 50); 1 uF on VREG_VIN (C18) and VREG_VOUT (C26).
BOOTSEL: hold SW1 while plugging USB in -> UF2 bootloader. R14 protects the QSPI_SS driver.
Crystal: Abracon ABM8-272-T3 (CL 10 pF, ESR 50 ohm) with 15 pF loads + 1k, exactly the RP2040 guide 2.3 circuit.
TESTEN tied to GND. RUN: 10k pull-up, SW6 RESET to GND, also on J2. BOOTSEL + tap RESET = UF2 mode.
GPIO: 0/1 UART0 -> TP1/TP2; 4/3/2 = keys A/B/C;
5-9 red LEDs; 10 WS2812 data (via U6); 11/22/25 SAO GPIO1;
12/13 SAO I2C0; 26-28 SAO GPIO2 (ADC0-2); 29 VBUS sense;
14-21, 23/24 free on J2 (SPI1, UART1).
USER INTERFACE keys, credit LEDs, RGB shelf
Keys A/B/C: active low, internal pull-ups, debounce in firmware.
Credit display: 5 red LEDs, 1k series -> ~1.5 mA each (dim by design).
WS2812B-2020-V6 x4 on VSYS, 100 nF each. GPIO10 -> U6 SN74LV1T34 (VCC = VSYS) -> DIN, so DIN swings to VSYS.
LED VDD spec is 3.7-5.3 V: firmware dims/stops the LEDs on low battery (VSYS < ~3.7 V). Chain out to J2 pin 19.
HACK HEADER J2 (DNP), test points, lanyard holes
2x13, 2.54 mm, not fitted - players solder their own pins. 3V3 logic only, no 5 V on the header.
Pin 1 = top-left square pad. GND on both end rows: a reversed ribbon shorts 3V3 to GND at worst (LDO limits).
10 free GPIO + SAO I2C/GPIO2 + SPK_PWM + SWD + RUN + RGB out. TP1-TP3: UART0 115200 8N1. H1/H2: 4.0 mm lanyard holes.
PWR_FLAGs: nets fed only through passive pins
(row 2: breakaway-module rails and grounds).
IMU MODULE breakaway board, plugs into J6
ST LSM6DS3TR-C 6-axis IMU (C967633), I2C mode (datasheet Mode 1): CS = VDDIO, SA0 = GND -> 0x6A,
SDx/SCx = GND, pins 10/11 NC. 100 nF on VDD (C30) and VDDIO (C31). I2C pull-ups are on the badge (R22/R23).
P2: SAO 2x3, 1 3V3, 2 GND, 3 SDA, 4 SCL, 5 GPIO1 = INT1 (GPIO11), 6 GPIO2 = INT2 (GPIO27). Plugs into J6.
SPEAKER MODULE breakaway board, plugs into J7
MLT-8530 magnetic transducer: 2.7 kHz resonance, 16 ohm,
<= 95 mA at 2.5-4.5 V, so it runs from the 3V3 LDO.
S8050 low-side switch, 1k base; 10k keeps it off while the
GPIO floats at reset. 1N4148W flyback, 10 uF local bulk.
Drive: 2.7 kHz square wave (50 % PWM) on GPIO25.
GPIO25 is also J2 pin 15 (shared).
P3: SAO 2x3, 1 = 3V3, 2 = GND, 5 = GPIO1 = SIG (J7).
Footprint wires the two dummy pads crosswise,
so a 180 deg placement only reverses the coil.
(BOM-B2 add-on 7.)
INTENT 2026 hardware badge - generated by 03-kicad/scripts/gen_sch.py from design.py (edit design.py, not this file).

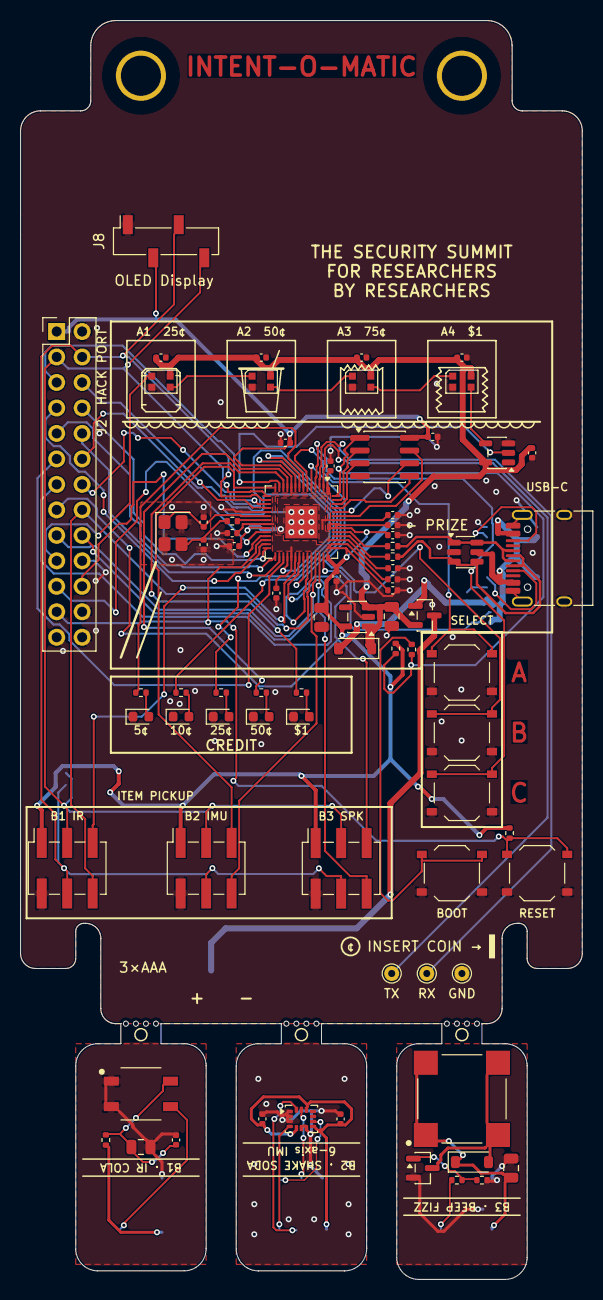
[picture p8: board intent-2026-badge.kicad_pcb from above]

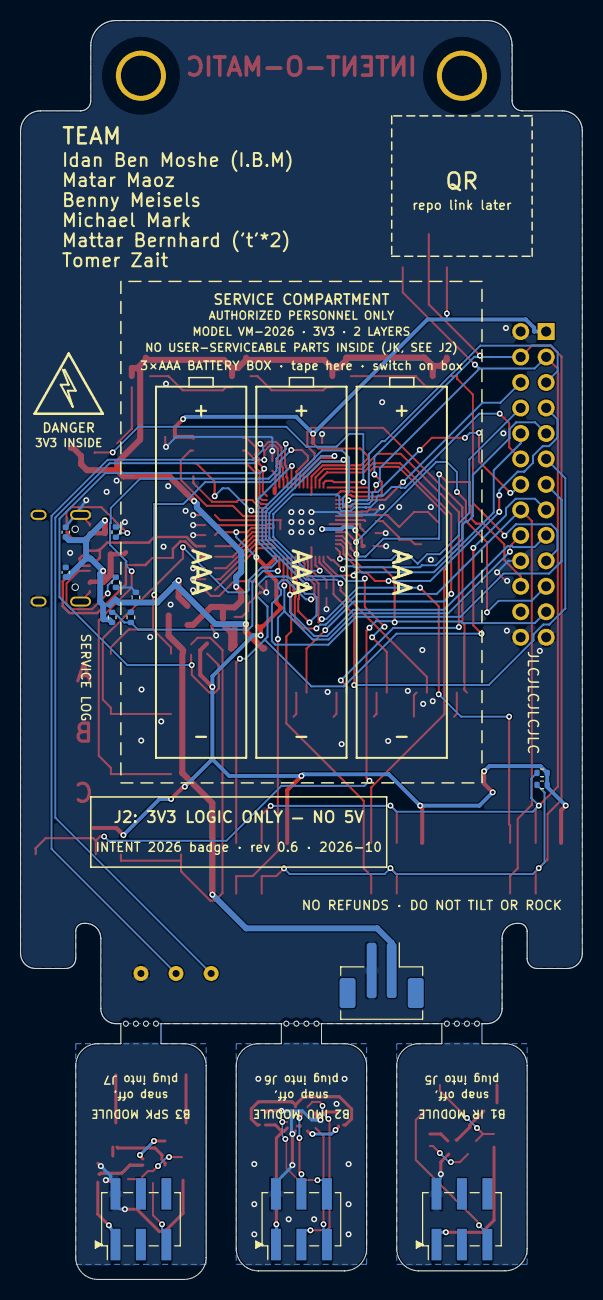
[picture p9: board intent-2026-badge.kicad_pcb from below]

Board: 2 copper layers, 56.0 x 125.5 mm, 95 parts (13 on the bottom side), 80 nets.

Other parts of the board:
MB1: tab IR; MouseBites_1x4_D0.5_P1.0
MB2: tab AUDIO; MouseBites_1x4_D0.5_P1.0
MB3: tab SPK; MouseBites_1x4_D0.5_P1.0
