MichaelMIL/intent2026/03-kicad/scripts/design.py

"""Single source of truth for the INTENT 2026 badge netlist (rev 0.6).

rev 0.6 (2026-10-17, schematic/BOM review against the RP2040 hardware design guide RP-008279-DS):
  * VREG decoupling per guide 2.1.3: C18 1 uF on VREG_VIN, new C26 1 uF on VREG_VOUT, C10 100 nF on DVDD pin 50
  * Y1 -> Abracon ABM8-272-T3 (C20625731, CL 10 pF), the guide's crystal for 15 pF loads + 1k
  * U3 -> AP2112K-3.3TRG1 (C51118, 600 mA, EN tied to VIN); C20 1 uF -> 10 uF
  * J1 -> HRO TYPE-C-31-M-12 (C165948), stock KiCad footprint (shield pad SH)
  * VBUS decoupling C27 1 uF + C28 100 nF (none before); reset button SW6 on RUN
  * RGB data buffer U6 SN74LV1T34 (C100024) on VSYS: DIN swings to VSYS, fixes VIH = 0.7 x VDD at any VSYS
  * Expansion ports -> SAO (badge.team): 2x3 socket J5-J7, 2x3 header P1-P3; pinout 1 3V3, 2 GND, 3 SDA,
    4 SCL, 5 GPIO1, 6 GPIO2. I2C0 on GPIO12/13 (4.7k pull-ups), GPIO1 = old slot signal, GPIO2 = GPIO26/27/28
  * 2026-10-29: the AUDIO module (PWM filter + 3.5 mm jack) became an IMU module: ST LSM6DS3TR-C (C967633) on the SAO
    I2C bus at 0x6A (SA0 = GND), INT1 -> SAO GPIO1 (GPIO11, net IMU_INT1), INT2 -> SAO GPIO2 (GPIO27). Nets IMM_*
  * 2026-10-18: SAO socket/header changed to SMT (C42163131 / C3294461); see bom-deltas for the keyed-connector check

rev 0.5 (2026-10-11): the IR receiver, the audio jack and a new speaker are **breakaway modules** on the same
PCB (under the pedestal, tab-routed with mouse bites). Each module has a 1x3 2.54 mm pin header (P1-P3) and
plugs into a matching socket on the main board (J5-J7). Module nets carry a module prefix (IRM_, AUM_, SPM_)
because no copper crosses the breakaway tabs; the sockets are the only link.
rev 0.5 port pinout was 1x3 (1 = GND, 2 = 3V3, 3 = signal); rev 0.6 uses the SAO 2x3 pinout above.

Derived from 01-spec/design-spec.md §2–§3 with the corrections found while
building the KiCad project (see 03-kicad/BUILD-NOTES.md):
  * R11/R12 27 Ω = C25100 (C25105 is 33 Ω)
  * U5 IRM-H638T pinout: 1,2 = GND, 3 = OUT, 4 = VCC
  * J4 PJ-320D (C431535) pads: 1 = S, 2 = R2, 3 = R1, 4 = T
"""

GND = 'GND'

# footprints ---------------------------------------------------------------
FP_R = 'Resistor_SMD:R_0402_1005Metric'
FP_C = 'Capacitor_SMD:C_0402_1005Metric'
FP_C0805 = 'Capacitor_SMD:C_0805_2012Metric'
FP_LED = 'LED_SMD:LED_0603_1608Metric'

# LCSC numbers -------------------------------------------------------------
L_100N = 'C60474'
L_1U = 'C6119792'
L_10U = 'C7503495'
L_15P = 'C1548'
L_10N = 'C15195'
L_10K = 'C25744'
L_4K7 = 'C25900'
L_1K = 'C11702'
L_5K1 = 'C25905'
L_27R = 'C25100'
L_100R = 'C25076'
# SAO connectors are SMT (user request 2026-10-18), so assembly needs no THT hand-soldering
L_SOCKET6 = 'C42163131'  # Hong Cheng HC-PM254-5.0H-2x3PS-02A, 2x3 2.54 mm SMD socket, 5.0 mm tall, SAO badge side
L_PINS6 = 'C3294461'     # HCTL PZ254-2-03-S, 2x3 2.54 mm SMD pin header, SAO add-on side
FP_SOCKET6 = 'Connector_PinSocket_2.54mm:PinSocket_2x03_P2.54mm_Vertical_SMD'
FP_PINS6 = 'Connector_PinHeader_2.54mm:PinHeader_2x03_P2.54mm_Vertical_SMD'

parts = []


def part(ref, lib, value, fp, lcsc, pins, dnp=False, in_bom=True, desc='', side='F', module=''):
    """module: '' = main board, else the breakaway module the part sits on ('IR', 'IMU', 'SPK')."""
    parts.append(dict(ref=ref, lib=lib, value=value, fp=fp, lcsc=lcsc, pins=pins,
                      dnp=dnp, in_bom=in_bom, desc=desc, side=side, module=module))


def R(ref, val, lcsc, a, b, desc='', module=''):
    part(ref, 'Device:R', val, FP_R, lcsc, {'1': a, '2': b}, desc=desc, module=module)


def C(ref, val, lcsc, a, b, fp=FP_C, desc='', module=''):
    part(ref, 'Device:C', val, fp, lcsc, {'1': a, '2': b}, desc=desc, module=module)


# ---- MCU --------------------------------------------------------------------
gpio = {i: None for i in range(30)}
gpio.update({0: 'UART0_TX', 1: 'UART0_RX', 2: 'BTN_C', 3: 'BTN_B', 4: 'BTN_A',   # A=GPIO4 (layout order)
             5: 'LED_R1', 6: 'LED_R2', 7: 'LED_R3', 8: 'LED_R4', 9: 'LED_R5',
             10: 'RGB_CTRL', 11: 'IMU_INT1', 12: 'SAO_SDA', 13: 'SAO_SCL', 22: 'IR_OUT', 25: 'SPK_PWM',
             26: 'SAO1_GPIO2', 27: 'SAO2_GPIO2', 28: 'SAO3_GPIO2', 29: 'VBUS_SENSE'})
for i in list(range(14, 22)) + [23, 24]:
    gpio[i] = 'GPIO%d' % i
gpio_pin = {0: 2, 1: 3, 2: 4, 3: 5, 4: 6, 5: 7, 6: 8, 7: 9, 8: 11, 9: 12, 10: 13, 11: 14, 12: 15, 13: 16,
            14: 17, 15: 18, 16: 27, 17: 28, 18: 29, 19: 30, 20: 31, 21: 32, 22: 34, 23: 35, 24: 36,
            25: 37, 26: 38, 27: 39, 28: 40, 29: 41}
u1 = {str(p): '+3V3' for p in (1, 10, 22, 33, 42, 49, 43, 44, 48)}
u1.update({'23': '+1V1', '50': '+1V1', '45': '+1V1', '57': GND, '19': GND,
           '20': 'XIN', '21': 'XOUT', '24': 'SWCLK', '25': 'SWDIO', '26': 'RUN',
           '46': 'USB_DM', '47': 'USB_DP', '51': 'QSPI_SD3', '52': 'QSPI_SCLK', '53': 'QSPI_SD0',
           '54': 'QSPI_SD2', '55': 'QSPI_SD1', '56': 'QSPI_SS'})
for g, p in gpio_pin.items():
    u1[str(p)] = gpio[g]
part('U1', 'MCU_RaspberryPi:RP2040', 'RP2040', 'Package_DFN_QFN:QFN-56-1EP_7x7mm_P0.4mm_EP3.2x3.2mm',
     'C2040', u1, desc='Dual Cortex-M0+ MCU')

part('U2', 'Memory_Flash:W25Q32JVSS', 'W25Q16JVSNIQ', 'Package_SO:SOIC-8_3.9x4.9mm_P1.27mm', 'C2456211',
     {'1': 'QSPI_SS', '2': 'QSPI_SD1', '3': 'QSPI_SD2', '4': GND, '5': 'QSPI_SD0', '6': 'QSPI_SCLK',
      '7': 'QSPI_SD3', '8': '+3V3'}, desc='16 Mbit QSPI flash')

part('Y1', 'Device:Crystal_GND24', '12MHz ABM8-272-T3', 'Crystal:Crystal_SMD_3225-4Pin_3.2x2.5mm', 'C20625731',
     {'1': 'XIN', '2': GND, '3': 'XOUT_R', '4': GND}, desc='12 MHz, CL 10 pF, ESR 50 ohm (RP2040 guide 2.3.1)')
C('C11', '15pF', L_15P, 'XIN', GND)
C('C12', '15pF', L_15P, 'XOUT_R', GND)
R('R13', '1k', L_1K, 'XOUT', 'XOUT_R')

# decoupling
for ref in ('C1', 'C2', 'C3', 'C4', 'C5', 'C17'):
    C(ref, '100nF', L_100N, '+3V3', GND, desc='IOVDD')
C('C6', '100nF', L_100N, '+3V3', GND, desc='flash VCC')
C('C7', '100nF', L_100N, '+3V3', GND, desc='USB_VDD')
C('C8', '100nF', L_100N, '+3V3', GND, desc='ADC_AVDD')
C('C18', '1uF', L_1U, '+3V3', GND, desc='VREG_VIN (1 uF, RP2040 guide 2.1.3)')
C('C19', '100nF', L_100N, '+1V1', GND, desc='DVDD pin 23')
C('C10', '100nF', L_100N, '+1V1', GND, desc='DVDD pin 50')
C('C26', '1uF', L_1U, '+1V1', GND, desc='VREG_VOUT (1 uF, RP2040 guide 2.1.3)')

R('R3', '10k', L_10K, 'QSPI_SS', '+3V3')
R('R4', '10k', L_10K, 'RUN', '+3V3')
R('R14', '1k', L_1K, 'QSPI_SS', 'BOOT_SW')
part('SW1', 'Switch:SW_Push', 'BOOTSEL', 'Button_Switch_SMD:SW_Push_1P1T_XKB_TS-1187A', 'C318884',
     {'1': 'BOOT_SW', '2': GND})
part('SW6', 'Switch:SW_Push', 'RESET', 'Button_Switch_SMD:SW_Push_1P1T_XKB_TS-1187A', 'C318884',
     {'1': 'RUN', '2': GND}, desc='Reset (RUN to GND); hold BOOTSEL + tap RESET for the UF2 bootloader')

# ---- USB --------------------------------------------------------------------
part('J1', 'Connector:USB_C_Receptacle_USB2.0_16P', 'TYPE-C-31-M-12', 'Connector_USB:USB_C_Receptacle_HRO_TYPE-C-31-M-12',
     'C165948',
     {'A1': GND, 'A12': GND, 'B1': GND, 'B12': GND, 'SH': GND,
      'A4': 'VBUS', 'A9': 'VBUS', 'B4': 'VBUS', 'B9': 'VBUS',
      'A5': 'CC1', 'B5': 'CC2', 'A6': 'USB_DP_CONN', 'B6': 'USB_DP_CONN', 'A7': 'USB_DM_CONN',
      'B7': 'USB_DM_CONN', 'A8': None, 'B8': None})
R('R1', '5.1k', L_5K1, 'CC1', GND)
R('R2', '5.1k', L_5K1, 'CC2', GND)
part('U4', 'Power_Protection:USBLC6-2SC6', 'USBLC6-2SC6', 'Package_TO_SOT_SMD:SOT-23-6', 'C2827654',
     {'1': 'USB_DP_CONN', '6': 'USB_DP_CONN', '3': 'USB_DM_CONN', '4': 'USB_DM_CONN', '2': GND, '5': 'VBUS'})
C('C27', '1uF', L_1U, 'VBUS', GND, desc='VBUS bulk (USB 2.0 allows <= 10 uF)')
C('C28', '100nF', L_100N, 'VBUS', GND, desc='VBUS / USBLC6 pin 5')
R('R11', '27', L_27R, 'USB_DP_CONN', 'USB_DP')
R('R12', '27', L_27R, 'USB_DM_CONN', 'USB_DM')

# ---- power path -------------------------------------------------------------
part('D6', 'Device:D_Schottky', 'B5819W', 'Diode_SMD:D_SOD-123', 'C7420330', {'1': 'VSYS', '2': 'VBUS'})
part('Q1', 'Transistor_FET:AO3401A', 'HL3401', 'Package_TO_SOT_SMD:SOT-23', 'C22469449',
     {'1': 'VBUS', '2': 'VSYS', '3': 'BAT_IN'})   # 2026-10-29: SW5/JP1 removed in the KiCad schematic, J3 feeds Q1 directly
R('R10', '10k', L_10K, 'VBUS', GND)
R('R15', '10k', L_10K, 'VBUS', 'VBUS_SENSE')
R('R16', '10k', L_10K, 'VBUS_SENSE', GND)
part('J3', 'Connector_Generic:Conn_01x02', 'BATT 3xAAA', 'Connector_JST:JST_PH_B2B-PH-SM4-TB_1x02-1MP_P2.00mm_Vertical',
     'C160352', {'1': 'BAT_IN', '2': GND}, desc='Battery box plug, JST B2B-PH-SM4-TB (C160352), pin1 = +')
C('C9', '10uF', L_10U, 'VSYS', GND, fp=FP_C0805, desc='LDO input')
part('U3', 'Regulator_Linear:AP2112K-3.3', 'AP2112K-3.3TRG1', 'Package_TO_SOT_SMD:SOT-23-5', 'C51118',
     {'1': 'VSYS', '2': GND, '3': 'VSYS', '4': None, '5': '+3V3'}, desc='3V3 LDO 600 mA, EN tied to VIN')
C('C20', '10uF', L_10U, '+3V3', GND, fp=FP_C0805, desc='LDO output')

# ---- UI -----------------------------------------------------------------------
for i, ref in enumerate(('SW2', 'SW3', 'SW4')):
    part(ref, 'Switch:SW_Push', 'ABC'[i], 'Button_Switch_SMD:SW_Push_1P1T_XKB_TS-1187A', 'C318884',
         {'1': 'BTN_' + 'ABC'[i], '2': GND})
for i in range(5):
    R('R%d' % (5 + i), '1k', L_1K, 'LED_R%d' % (i + 1), 'LED_A%d' % (i + 1))
    part('D%d' % (i + 1), 'Device:LED', 'Red', FP_LED, 'C2286', {'1': GND, '2': 'LED_A%d' % (i + 1)})

part('U6', 'Logic_LevelTranslator:SN74LV1T34DBV', 'SN74LV1T34DBVR', 'Package_TO_SOT_SMD:SOT-23-5', 'C100024',
     {'1': None, '2': 'RGB_CTRL', '3': GND, '4': 'RGB_DIN', '5': 'VSYS'},
     desc='RGB data buffer: 3V3 in, VSYS out (VCC 1.6-5.5 V, 5.5 V tolerant input)')
C('C29', '100nF', L_100N, 'VSYS', GND, desc='U6 VCC')
rgb_chain = ['RGB_DIN', 'RGB_D2', 'RGB_D3', 'RGB_D4', 'RGB_DOUT']
for i in range(4):
    part('LED%d' % (i + 1), 'LED:WS2812B-2020', 'WS2812B-2020-V6', 'LED_SMD:LED_WS2812B-2020_PLCC4_2.0x2.0mm',
         'C52917434', {'3': rgb_chain[i], '1': rgb_chain[i + 1], '4': 'VSYS', '2': GND})
    C('C%d' % (13 + i), '100nF', L_100N, 'VSYS', GND, desc='LED%d VDD' % (i + 1))

# ---- expansion ports (main board): SAO (badge.team), 2x3 2.54 mm socket ---------
# 1 = 3V3, 2 = GND, 3 = SDA, 4 = SCL, 5 = GPIO1, 6 = GPIO2. Shared I2C0 bus (GPIO12/13), GPIO1 = the slot signal of
# rev 0.5, GPIO2 = GPIO26/27/28 (ADC-capable). The module side is P1-P3 below.
SAO_PORTS = (('J5', 'SAO1 IR', 'IR_OUT', 'SAO1_GPIO2'), ('J6', 'SAO2 IMU', 'IMU_INT1', 'SAO2_GPIO2'),
             ('J7', 'SAO3 SPK', 'SPK_PWM', 'SAO3_GPIO2'))
for ref, name, g1, g2 in SAO_PORTS:
    part(ref, 'Connector_Generic:Conn_02x03_Odd_Even', name, FP_SOCKET6, L_SOCKET6,
         {'1': '+3V3', '2': GND, '3': 'SAO_SDA', '4': 'SAO_SCL', '5': g1, '6': g2},
         desc='SAO port: 1 3V3, 2 GND, 3 SDA, 4 SCL, 5 GPIO1 = %s, 6 GPIO2 = %s' % (g1, g2))
R('R22', '4.7k', L_4K7, 'SAO_SDA', '+3V3', desc='I2C0 SDA pull-up')
R('R23', '4.7k', L_4K7, 'SAO_SCL', '+3V3', desc='I2C0 SCL pull-up')
# 0.96" I2C OLED module (SSD1306, 4-pin GND/VCC/SCL/SDA) on the same I2C0 bus (2026-10-29). SMD 1x4 socket, staggered
# pins starting right ("YQ"); placement is Benny's in KiCad.
part('J8', 'Connector_Generic:Conn_01x04', 'OLED 0.96 I2C', 'Connector_PinSocket_2.54mm:PinSocket_1x04_P2.54mm_Vertical_SMD_Pin1Right',
     'C42379197', {'1': GND, '2': '+3V3', '3': 'SAO_SCL', '4': 'SAO_SDA'},
     desc='0.96 inch I2C OLED module: 1 GND, 2 VCC (3V3), 3 SCL, 4 SDA')

# ---- IR module (breakaway, nets IRM_*) ------------------------------------------
M = 'IR'
SAO_NC = {'3': None, '4': None, '6': None}
part('P1', 'Connector_Generic:Conn_02x03_Odd_Even', 'IR MODULE', FP_PINS6, L_PINS6,
     dict(SAO_NC, **{'1': 'IRM_3V3', '2': 'IRM_GND', '5': 'IRM_OUT'}), desc='SAO add-on header (GPIO1 = OUT)', module=M)
part('U5', 'Interface_Optical:IRM-H6xxT', 'IRM-H638T/TR2', 'intent:IRM-H638T_C91447', 'C91447',
     {'1': 'IRM_GND', '2': 'IRM_GND', '3': 'IRM_OUT', '4': 'IRM_VCC'}, module=M)
R('R19', '100', L_100R, 'IRM_3V3', 'IRM_VCC', module=M)
C('C23', '100nF', L_100N, 'IRM_VCC', 'IRM_GND', module=M)
C('C24', '10uF', L_10U, 'IRM_VCC', 'IRM_GND', fp=FP_C0805, module=M)

# ---- IMU module (breakaway, nets IMM_*) - was the audio module until 2026-10-29 ------
M = 'IMU'
part('P2', 'Connector_Generic:Conn_02x03_Odd_Even', 'IMU MODULE', FP_PINS6, L_PINS6,
     {'1': 'IMM_3V3', '2': 'IMM_GND', '3': 'IMM_SDA', '4': 'IMM_SCL', '5': 'IMM_INT1', '6': 'IMM_INT2'},
     desc='SAO add-on header: I2C to the badge, GPIO1 = INT1, GPIO2 = INT2', module=M)
# LSM6DS3TR-C in I2C mode (datasheet Mode 1): CS = VDDIO, SA0 = GND (address 0x6A), SDx/SCx = GND, pins 10/11 NC;
# 100 nF on VDD and on VDDIO (datasheet note 1). SDA/SCL pull-ups are on the badge (R22/R23).
part('U7', 'Sensor_Motion:LSM6DS3', 'LSM6DS3TR-C', 'Package_LGA:LGA-14_3x2.5mm_P0.5mm_LayoutBorder3x4y', 'C967633',
     {'1': 'IMM_GND', '2': 'IMM_GND', '3': 'IMM_GND', '4': 'IMM_INT1', '5': 'IMM_3V3', '6': 'IMM_GND', '7': 'IMM_GND',
      '8': 'IMM_3V3', '9': 'IMM_INT2', '10': None, '11': None, '12': 'IMM_3V3', '13': 'IMM_SCL', '14': 'IMM_SDA'},
     desc='6-axis IMU (accel + gyro), I2C 0x6A', module=M)
C('C30', '100nF', L_100N, 'IMM_3V3', 'IMM_GND', desc='U7 VDD', module=M)
C('C31', '100nF', L_100N, 'IMM_3V3', 'IMM_GND', desc='U7 VDDIO', module=M)

# ---- speaker module (breakaway, nets SPM_*) — BOM-B2 add-on 7 ---------------------
M = 'SPK'
part('P3', 'Connector_Generic:Conn_02x03_Odd_Even', 'SPK MODULE', FP_PINS6, L_PINS6,
     dict(SAO_NC, **{'1': 'SPM_3V3', '2': 'SPM_GND', '5': 'SPM_SIG'}), desc='SAO add-on header (GPIO1 = SIG)', module=M)
R('R20', '1k', L_1K, 'SPM_SIG', 'SPM_BASE', desc='base resistor', module=M)
R('R21', '10k', L_10K, 'SPM_BASE', 'SPM_GND', desc='keeps Q2 off while the GPIO floats', module=M)
part('Q2', 'Transistor_BJT:Q_NPN_BEC', 'S8050', 'Package_TO_SOT_SMD:SOT-23', 'C2146',
     {'1': 'SPM_BASE', '2': 'SPM_GND', '3': 'SPM_COL'}, desc='NPN low-side driver', module=M)
part('LS1', 'Device:Buzzer', 'MLT-8530', 'intent:Buzzer_MLT-8530_C94599', 'C94599',
     {'1': 'SPM_3V3', '2': 'SPM_COL'}, desc='Magnetic transducer 2.7 kHz, 16 ohm, 95 mA max', module=M)
part('D7', 'Diode:1N4148W', '1N4148W', 'Diode_SMD:D_SOD-123', 'C81598',
     {'1': 'SPM_3V3', '2': 'SPM_COL'}, desc='flyback', module=M)
C('C25', '10uF', L_10U, 'SPM_3V3', 'SPM_GND', fp=FP_C0805, desc='module bulk', module=M)

# ---- header / test --------------------------------------------------------------
j2 = {1: '+3V3', 2: GND, 3: 'SAO_SDA', 4: 'SAO_SCL', 5: 'GPIO14', 6: 'GPIO15', 7: 'GPIO16', 8: 'GPIO17',
      9: 'GPIO18', 10: 'GPIO19', 11: 'GPIO20', 12: 'GPIO21', 13: 'GPIO23', 14: 'GPIO24', 15: 'SPK_PWM',
      16: 'SAO1_GPIO2', 17: 'SAO2_GPIO2', 18: 'SAO3_GPIO2', 19: 'RGB_DOUT', 20: GND, 21: 'SWCLK', 22: 'SWDIO',
      23: 'RUN', 24: GND, 25: GND, 26: GND}
part('J2', 'Connector_Generic:Conn_02x13_Odd_Even', 'HACK HEADER', 'Connector_PinHeader_2.54mm:PinHeader_2x13_P2.54mm_Vertical',
     '', {str(k): v for k, v in j2.items()}, dnp=True, in_bom=False, desc='2x13 expansion / SWD, DNP')
part('TP1', 'Connector:TestPoint', 'TX', 'TestPoint:TestPoint_THTPad_D1.5mm_Drill0.7mm', '', {'1': 'UART0_TX'}, in_bom=False)
part('TP2', 'Connector:TestPoint', 'RX', 'TestPoint:TestPoint_THTPad_D1.5mm_Drill0.7mm', '', {'1': 'UART0_RX'}, in_bom=False)
part('TP3', 'Connector:TestPoint', 'GND', 'TestPoint:TestPoint_THTPad_D1.5mm_Drill0.7mm', '', {'1': GND}, in_bom=False)
part('H1', 'Mechanical:MountingHole', 'Lanyard', 'intent:LanyardHole_4.0mm_Plated', '', {}, in_bom=False)
part('H2', 'Mechanical:MountingHole', 'Lanyard', 'intent:LanyardHole_4.0mm_Plated', '', {}, in_bom=False)

PWR_FLAGS = ['GND', 'VBUS', 'VSYS', 'IRM_VCC', 'IRM_3V3', 'IRM_GND', 'IMM_3V3', 'IMM_GND', 'SPM_3V3', 'SPM_GND']

# breakaway modules: name -> ground net (zones) and the socket it mates with
MODULES = {'IR': dict(gnd='IRM_GND', socket='J5', pins='P1'),
           'IMU': dict(gnd='IMM_GND', socket='J6', pins='P2'),
           'SPK': dict(gnd='SPM_GND', socket='J7', pins='P3')}

if __name__ == '__main__':
    from collections import defaultdict
    nets = defaultdict(list)
    for p in parts:
        for pin, n in p['pins'].items():
            if n:
                nets[n].append(p['ref'] + '.' + pin)
    for n in sorted(nets):
        print('%-14s %3d  %s' % (n, len(nets[n]), ' '.join(nets[n][:12])))
    print(len(parts), 'parts', len(nets), 'nets')
