MichaelMIL/intent2026/03-kicad/scripts/gen_3d.py

"""Simple VRML 3D models (boxes and cylinders) for the footprints that have no model in the KiCad install:
the custom parts in intent.pretty and three stock footprints whose STEP files are not shipped with KiCad 10
(TS-1187A switch, WS2812B-2020, MSK12C02). Output: ../intent.3dshapes/*.wrl

Geometry is authored in footprint coordinates (mm, x right, y DOWN as on the PCB, z up) and converted to the
KiCad VRML convention (0.1 inch units, y up). Dimensions come from the datasheets / JLC footprints.
"""
import os, math

OUT = os.path.join(os.path.dirname(os.path.abspath(__file__)), '..', 'intent.3dshapes')
os.makedirs(OUT, exist_ok=True)
U = 1 / 2.54
BLACK = (0.10, 0.10, 0.10)
DARK = (0.20, 0.20, 0.22)
METAL = (0.78, 0.78, 0.80)
WHITE = (0.92, 0.92, 0.88)
BEIGE = (0.90, 0.86, 0.72)
LENS = (0.25, 0.20, 0.20)
YELLOW = (0.95, 0.85, 0.45)


def _pt(x, y, z):
    return '%.4f %.4f %.4f' % (x * U, -y * U, z * U)


def _shape(color, points, faces):
    pts = ', '.join(_pt(*p) for p in points)
    idx = ', '.join(' '.join(str(i) for i in f) + ' -1' for f in faces)
    return ('Shape {\n appearance Appearance { material Material { diffuseColor %.2f %.2f %.2f specularColor 0.3 0.3 0.3 shininess 0.2 } }\n'
            ' geometry IndexedFaceSet { solid FALSE coord Coordinate { point [ %s ] } coordIndex [ %s ] }\n}\n'
            % (color[0], color[1], color[2], pts, idx))


def box(x1, y1, x2, y2, z1, z2, color):
    p = [(x1, y1, z1), (x2, y1, z1), (x2, y2, z1), (x1, y2, z1), (x1, y1, z2), (x2, y1, z2), (x2, y2, z2), (x1, y2, z2)]
    f = [(0, 3, 2, 1), (4, 5, 6, 7), (0, 1, 5, 4), (1, 2, 6, 5), (2, 3, 7, 6), (3, 0, 4, 7)]
    return _shape(color, p, f)


def cyl(cx, cy, cz, r, length, axis, color, n=24):
    """Cylinder centred at (cx, cy, cz) along axis 'x', 'y' or 'z' with the given length."""
    pts = []
    for k in range(n):
        a = 2 * math.pi * k / n
        for s in (-0.5, 0.5):
            u, v, w = r * math.cos(a), r * math.sin(a), s * length
            if axis == 'z':
                pts.append((cx + u, cy + v, cz + w))
            elif axis == 'x':
                pts.append((cx + w, cy + u, cz + v))
            else:
                pts.append((cx + u, cy + w, cz + v))
    faces = []
    for k in range(n):
        a, b = 2 * k, 2 * ((k + 1) % n)
        faces.append((a, b, b + 1, a + 1))
    faces.append(tuple(2 * k for k in range(n)))
    faces.append(tuple(2 * k + 1 for k in range(n - 1, -1, -1)))
    return _shape(color, pts, faces)


def write(name, body):
    with open(os.path.join(OUT, name + '.wrl'), 'w', newline='\n') as f:
        f.write('#VRML V2.0 utf8\n# %s - generated by 03-kicad/scripts/gen_3d.py (simplified model)\n' % name + body)


MODELS = {
    # USB-C 16-pin receptacle C393939: shell 8.94 x 7.3 x 3.26 mm, mouth toward +Y, pads at the -Y end
    'USB_C_TYPE-C16PIN_C393939': box(-4.47, -2.34, 4.47, 4.96, 0, 3.26, METAL) + box(-3.9, 3.5, 3.9, 5.0, 0.7, 2.6, BLACK)
                                 + box(-2.8, 1.0, 2.8, 5.0, 1.45, 1.85, DARK),
    # PJ-320D 3.5 mm jack: body 12 x 6 x 5, barrel 2 mm long on the -X end
    'Jack_3.5mm_PJ-320D_SMD_C431535': box(-7.3, -3.0, 4.7, 3.0, 0, 5.0, BLACK) + cyl(-8.3, 0, 2.5, 2.5, 2.0, 'x', METAL)
                                      + cyl(-9.25, 0, 2.5, 1.85, 0.15, 'x', BLACK),
    # IRM-H638T: 4.0 x 5.0 x 3.4 body, lens on top at (0, -0.76)
    'IRM-H638T_C91447': box(-2.0, -2.5, 2.0, 2.5, 0, 2.6, BLACK) + cyl(0, -0.76, 2.6, 1.5, 0.8, 'z', LENS)
                        + box(-3.7, -1.72, -2.0, -0.82, 0, 0.3, METAL) + box(-3.7, 0.82, -2.0, 1.72, 0, 0.3, METAL)
                        + box(2.0, -1.72, 3.7, -0.82, 0, 0.3, METAL) + box(2.0, 0.82, 3.7, 1.72, 0, 0.3, METAL),
    # JST PH 2-pin SMD vertical (PH2.0-2P-LT): 7.9 x 4.5 x 6.0, opening on top
    'JST_PH_2P_SMD_Vertical_C722761': box(-3.95, -4.6, 3.95, 0.6, 0, 6.0, BEIGE) + box(-2.6, -3.6, 2.6, -0.4, 4.0, 6.01, DARK)
                                      + box(-1.3, -2.3, -0.7, -1.7, 1.0, 6.0, METAL) + box(0.7, -2.3, 1.3, -1.7, 1.0, 6.0, METAL),
    # MLT-8530 transducer: 8.5 x 8.5 x 3.0, sound port on the -Y side
    'Buzzer_MLT-8530_C94599': box(-4.25, -4.25, 4.25, 4.25, 0, 3.0, BLACK) + cyl(0, -4.26, 1.6, 0.5, 0.2, 'y', DARK)
                              + box(-1.2, 2.4, -0.0, 4.8, 0, 0.2, METAL) + box(0.0, 2.4, 1.2, 4.8, 0, 0.2, METAL),
    # TS-1187A tactile switch: 5.1 x 5.1 x 1.5 with a round actuator
    'SW_Push_1P1T_XKB_TS-1187A': box(-2.55, -2.55, 2.55, 2.55, 0, 0.5, BLACK) + box(-2.55, -2.55, 2.55, 2.55, 0.5, 1.1, METAL)
                                 + cyl(0, 0, 1.3, 1.4, 0.4, 'z', BLACK),
    # WS2812B-2020: 2.0 x 2.0 x 0.9, white body, yellow die window
    'LED_WS2812B-2020_PLCC4_2.0x2.0mm': box(-1.0, -1.0, 1.0, 1.0, 0, 0.9, WHITE) + box(-0.6, -0.6, 0.6, 0.6, 0.9, 0.95, YELLOW),
    # MSK12C02 slide switch: 8.6 x 3.7 x 2.4 body, knob toward -Y (actuation along X)
    'SW_SPDT_Shouhan_MSK12C02': box(-4.3, -1.85, 4.3, 1.85, 0, 2.4, METAL) + box(-1.2, -3.2, 1.2, -1.85, 0.6, 2.0, BLACK),
}

if __name__ == '__main__':
    for n, b in MODELS.items():
        write(n, b)
    print('3D models ->', os.path.abspath(OUT), len(MODELS))
