MichaelMIL/intent2026/(commit log)

2026-10-11 INTENT 2026 badge rev 0.5: breakaway IR / audio / speaker modules
    RP2040 vending-machine badge, KiCad project generated from scripts
    (design.py netlist, placement.py coordinates, gen_sch.py wired schematic,
    custom grid router) plus spec, BOM and fab outputs for JLCPCB.
    rev 0.5: the IR receiver, the audio jack and a new speaker (MLT-8530 +
    S8050 + 1N4148W) sit on three breakaway modules under the pedestal
    (56 x 118 mm blank, 4 mm tabs with mouse bites). Each module has a 1x3 pin
    header and plugs into a 1x3 socket on the main board (J5 IR / J6 AUDIO /
    J7 SPK; pin 1 GND, 2 3V3, 3 signal). Module nets are separate, no copper
    crosses a tab. ERC 0 errors, DRC 0 violations / 0 unconnected (KiCad 1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
    [bom_jlc.csv, intent-2026-badge.kicad_pcb, intent-2026-badge.kicad_sch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]
2026-10-11 Add README with board renders and schematic PDF link
2026-10-11 Add simplified 3D models for footprints without one; refresh renders
    gen_3d.py writes VRML boxes/cylinders for the custom footprints (USB-C,
    PJ-320D, IRM-H638T, JST-PH, MLT-8530) and for TS-1187A, WS2812B-2020 and
    MSK12C02, whose STEP models KiCad 10 does not ship. Footprints and the
    board reference them; front/back renders regenerated.
    [intent-2026-badge.kicad_pcb]
2026-10-11 Vending-machine theme: themed silkscreen, modules as vended items with shaped outlines
    - silk.py: shelf items A1-A4 with price tags over a dispensing coil, keypad bezel + SELECT,
    CREDIT meter with coin values, ITEM PICKUP door around slots B1/B2/B3, coin slot,
    back service-panel texts (SERVICE COMPARTMENT, model plate, NO REFUNDS)
    - modules: B1 EYE CANDY candy bar (crimped edges, 1.2 mm chamfers), B2 AUDIO POP soda can
    (R 2.5 corners, bubbles), B3 BEEP CHIPS chips bag (crimped edges, 2 mm chamfers)
    - placement.MODULE_CORNERS + pcb_build.module_perimeter/add_module_edges draw the corners
    - board, gerbers, renders, DRC/ERC reports regenerated (DRC 0 violations); docs updated
    Co-Authored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
    [bom_jlc.csv, intent-2026-badge.kicad_pcb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]
2026-10-11 Vending-machine outline: header sign box with lanyard holes, modules as 13x22 mm soda cans
    - pcb_build OUTLINE: R6 top replaced by a header sign box x 7-49 x y 0-9 (R2.5 corners, R1 fillets,
    R2 cabinet corners); H1/H2 moved to (12,5.5)/(44,5.5); INTENT-O-MATIC marquee; logo 1 mm lower
    - placement: MODULES = cans 13x22 R2.2 at x 5.5/21.5/37.5, tabs 12/28/44, blank 56x124;
    module parts re-placed (header at the can bottom, passives in a row)
    - silk: can rims, label band with wave, B1 IR COLA / B2 AUDIO POP / B3 BEEP FIZZ
    - router: NY 1270, NET_ONLY mode + router/prune_routes.py for partial re-routes; only module
    nets re-routed (97 tracks, 14 vias), main-board copper unchanged except 8 pru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
    [bom_jlc.csv, intent-2026-badge.kicad_pcb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]
2026-10-11 Vending-machine art pass: feet, exposed-copper logo/marquee/keys/can rims, product icons, back art
    - pcb_build OUTLINE: feet x 0-5.5 / 50.5-56, y 88-94.5 with a 2.5 mm notch to the pedestal (additive)
    - art_copper.py (new, called by pcb_finish): INTENT logo, INTENT-O-MATIC, A/B/C, BOOT as F.Cu + F.Mask,
    can rims as mask openings; placement.ART_KEEPOUTS; prune_routes --art drops GND vias there (28)
    - silk: product icons around the shelf LEDs, glass glare, coin, pull-tab rings on the can stubs;
    back: three AAA cells, DANGER 3V3 INSIDE sticker, SERVICE LOG
    - placement and signal routing unchanged; DRC 0 violations, 0 unconnected; fab outputs, renders, docs
    regenerated; order-spec recommen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
    [intent-2026-badge.kicad_pcb]
2026-10-13 Regenerate fab outputs (gerbers, JLC BOM, CPL) from the art-pass board
2026-10-18 Rev 0.6: RP2040 design-guide review, SAO ports, re-layout, hand MCU re-route
    Schematic/BOM (design.py, gen_sch.py):
    - VREG decoupling per the RP2040 hardware design guide: 1 uF on VREG_VIN (C18)
    and VREG_VOUT (new C26), C10 100 nF on DVDD 50
    - Y1 -> ABM8-272-T3 (C20625731), U3 -> AP2112K-3.3 (C51118) with 10 uF out,
    J1 -> HRO TYPE-C-31-M-12 (C165948), VBUS caps C27/C28, RESET button SW6
    - RGB data buffer U6 SN74LV1T34 on VSYS (+C29)
    - Expansion ports -> SAO 2x3 SMD sockets/headers, I2C0 on GPIO12/13 with
    4.7k pull-ups, GPIO2 on GPIO26-28; C22 now 0603
    - ERC 0 errors / 0 warnings, netlist check 0 problems
    PCB (placement.py, silk.py, art_copper.py, route2.py):
    - RP2040 core re-placed af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
    [bom_jlc.csv, intent-2026-badge.kicad_pcb, intent-2026-badge.kicad_sch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]
2026-10-18 Board: more hand routing (26 unconnected left per DRC)
    [intent-2026-badge.kicad_pcb]
2026-10-18 Board: routing complete (DRC 0 errors, 0 unconnected), fab outputs regenerated
    Benny's hand routing plus the scripted GND fixes (U1 exposed-pad vias,
    stitching vias, IR module pour joint). Gerbers, JLC BOM/CPL, DRC/ERC reports
    and renders regenerated from this board. Review notes in BUILD-NOTES item 17.
    [intent-2026-badge.kicad_pcb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]
2026-10-29 J3 -> JST B2B-PH-SM4-TB (C160352), drop SW5/JP1
    - J3 battery-box plug is now a genuine JST PH 2-pin SMD vertical
    (C160352) on the stock KiCad footprint; pin 1 = BAT_IN, pin 2 = GND.
    - SW5 and JP1 removed (Benny's schematic edit): J3 feeds Q1 directly.
    design.py, gen_sch.py, placement.py, silk.py synced to the KiCad
    schematic (check_sch: 313 pins, 78 nets, 0 problems).
    - PCB: J3 footprint swapped in place, SW5/JP1 removed, JP1 pads bridged,
    SW5 stubs deleted. DRC 0 errors, 0 unconnected.
    - 04-fab regenerated; BOM deltas (EN + HE), BUILD-NOTES item 19, CLAUDE.md.
    [bom_jlc.csv, intent-2026-badge.kicad_pcb, intent-2026-badge.kicad_sch]
2026-10-29 IMU module replaces the audio module; module SAO headers rotated 90 deg
    - B2 module: ST LSM6DS3TR-C (C967633) on the SAO I2C bus at 0x6A,
    INT1 -> GPIO11 (net IMU_INT1), INT2 -> GPIO27, 100 nF on VDD/VDDIO.
    Jack, PWM filter (J4, R17, C21, C22) removed; nets AUM_* -> IMM_*.
    - Module headers P1-P3 at rot 90 like the badge sockets; speaker-can
    driver row moved to the back; module silk redrawn.
    - PCB edits on the hand-routed board: only module copper re-routed;
    Benny's J3/BAT_IN edit kept. DRC 0 errors, 0 unconnected.
    - 04-fab regenerated; BOM deltas EN/HE, BUILD-NOTES 20/21, GPIO map.
    [bom_jlc.csv, intent-2026-badge.kicad_pcb, intent-2026-badge.kicad_sch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]
2026-10-29 Add J8, 4-pin I2C socket for a 0.96" OLED module
    - J8: 1x4 2.54 mm SMD female socket (C42379197), 1 GND, 2 3V3, 3 SCL,
    4 SDA on the SAO I2C bus; placed by Benny under the logo.
    - Routed locally to the existing +3V3 / SAO_SCL / SAO_SDA copper.
    DRC 0 errors, 0 unconnected. 04-fab regenerated; BOM deltas EN/HE,
    BUILD-NOTES item 22.
    [bom_jlc.csv, intent-2026-badge.kicad_pcb, intent-2026-badge.kicad_sch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]
2026-10-29 Module SAO headers to the can backs; order spec for two-sided SMT assembly
    P1-P3 move to B.Cu (rot 270, same pad pattern as J5-J7) so the modules plug in
    face-up. Speaker driver row back on the front, module silk adjusted, module nets
    re-routed. DRC 0 errors / 0 unconnected; fab outputs regenerated.
    [intent-2026-badge.kicad_pcb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]
2026-10-29 Module SAO headers turned 180 deg so the plugged modules hang down
    P1-P3 stay on the can backs at rot 90 (pin 1 bottom-right seen from the front); a
    module plugs in face-up below its socket instead of covering D1-D5. Back pin-1
    marks moved, module nets re-routed. DRC 0 errors / 0 unconnected; fab outputs
    regenerated.
    [intent-2026-badge.kicad_pcb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]
2026-10-29 Module can art turned 180 deg to read upright when plugged in; IMU front pour restored
    Front can texts rotated (silk.py + board). 11 IMM_GND stitching vias bring back
    the IMU can's front ground pour, which the last re-route had left as a removed
    island. DRC 0 errors / 0 unconnected; fab outputs regenerated.
    [intent-2026-badge.kicad_pcb]
2026-10-29 Module back texts turned 180 deg to match the hanging modules
    [intent-2026-badge.kicad_pcb]
2026-10-29 Speaker can gets a horizontal label band; module back texts back to the original orientation
    [intent-2026-badge.kicad_pcb]
2026-10-29 Module back texts turned 180 deg again; stale SW5/JP1/J3 back-silk notes removed
    [intent-2026-badge.kicad_pcb]
2026-10-29 Board: Benny's KiCad silk edits (IR can 38k text removed, tagline merged)
    [intent-2026-badge.kicad_pcb]
